xiaoshubaoVIP/XP02_WR/File/XP02/03 详设方案/05 PCBA生产文件/PCB板,XP02主板PCB,FR-4,94V0,板厚1.6mm,黑油白字,双层板/gerber/钢网拼板资料/钢网制作要求/钢网制作要求.docx

如图：

钢网开孔，把中间孔堵住。

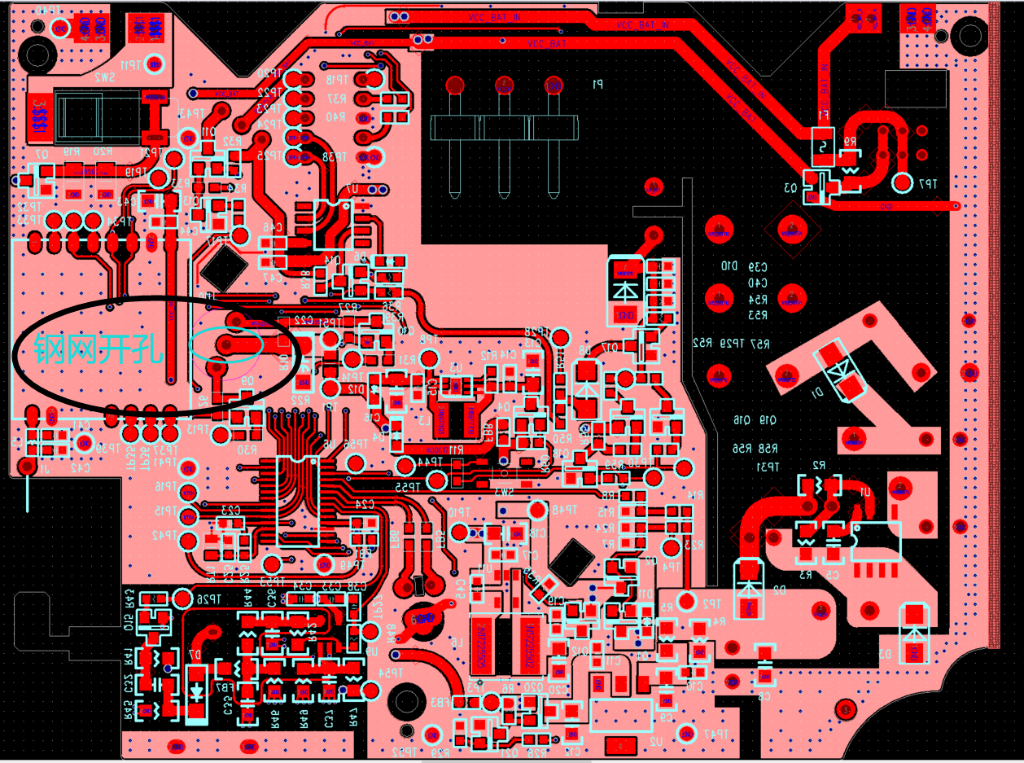
[picture p12: figure]
