xiaoshubaoVIP/XP02_WR/File/XP02/03 详设方案/04 PCB文件/PCB板,XP01_V2.0主板PCB,FR-4,94V0,板厚1.6mm,黑油白字,双层板/BOM--SMD和PCBA加工物料/PCBA,XP01主板,TUVUL,BA45F5260方案,复合烟雾碳感报警器.xlsx

BOM层级 | 子项物料编码 | 物料名称 | 规格型号 | 单位 | 实际数量 | 位置号 | 备注
0 |  |  |  | Pcs | 1
.1 | Y.2.12.XP0103 | 第八版新迷宫组件 | 迷宫组件,第八版新迷宫,PC 945NC,集耀对管 | Pcs | 1 | 主板位号U2
..2 | Y.2.01.XP0105 | 新迷宫上盖 | 第八版新迷宫上盖,XP01,PC 945NC,黑色抽粒料 | Pcs | 1
..2 | Y.2.02.XP0102 | 新迷宫下盖 | 第八版新迷宫下盖,XP01,PC 945NC,黑色抽粒料 | Pcs | 1
..2 | Y.2.07.XP0101 | 迷宫对管支架 | 迷宫对管支架,XP01,PC+ABS(AC3100),黑色 | Pcs | 1
..2 | Y.1.11.010010 | 红外发射管 | 集耀,940/L30022NC-4.3-V/L100887 | Pcs | 1
..2 | Y.1.11.010011 | 接射管 | 集耀,L30025PDC-4.3-V/L100888 | Pcs | 1
.1 | P.2.03.000022 | 电池 | BAT,锂电池,XP01,DC3V,CR17450,带电极焊片,插件,惠德瑞 | Pcs | 1
.1 | Y.1.30.010008 | 蜂鸣器 | 蜂鸣器,XP01,黑色,带耳朵,带线长50mm,带插座间距1.25mm,直径30.4mm,高度19mm,频率3.2KHZ(取消蜂鸣器内部电阻) | Pcs | 1 | 主板位号J6
.1 | Y.1.16.010006 | 连接线 | 连接线,1x4PIN,A面对B面,1.25mm,软线材,长50mm | Pcs | 1 | 主板位号CON3与XP01按键板J1连接
.1 | Y.1.29.010003 | CO传感器 | CO Sensor,一氧化碳传感器,Figaro,TGS5042-A00 | Pcs | 1 | 主板位号TP27/TP26
.1 | T.03.XP.01001 | PCBA | PCBA,XP01按键板 | Pcs | 1
..2 | T.04.XP.01007 | PCB板 | PCB板,XP01按键板PCB,FR-4,94V0,板厚1mm,黑油白字,双层板(2021-12-7) | Pcs | 1
..2 | Y.1.02.020049 | 电阻 | RES,SMD,100R,5%J,1/16W,0402 | Pcs | 4 | R1,R2,R3,R4
..2 | Y.1.09.020037 | 贴片LED | 侧面红色led发光二极管,贴片0805封装 | Pcs | 2 | D1,D2
..2 | Y.1.09.020038 | 贴片LED | 侧面绿色led发光二极管,贴片0805封装 | Pcs | 2 | D3,D4
..2 | Y.1.20.020023 | 贴片按键 | KEY,轻触按键,K2-8816SP-A5SW-01 300G,防腐蚀,8*8.7*4mm,RoHS | Pcs | 1 | KEY1
..2 | Y.1.19.020054 | 立式连接座 | CONN,连接座,1x4PIN,SMT,1.25mm,Vertical,RoHS | Pcs | 1 | J1
.1 |  | PCBA | PCBA,XP01主板,TUV/UL,BA45F5260方案,复合烟雾碳感报警器 | Pcs | 1
..2 |  | PCB板 | PCB,XP01,V0.1,主板,FR4,96*85.3,板厚1.6mm,双层板,沉金,黑油白字,阻抗控制（BA45F5260方案） | Pcs | 1
..2 | Y.1.03.020082 | 电容 | CAP,陶瓷电容,SMD,22uF,20%M,16V,X5R,0805 | Pcs | 3 | C1,C2,C21
..2 | Y.1.03.020093 | 电容 | CAP,陶瓷电容,SMD,100nF,10%K,50V,X7R,0603 | Pcs | 6 | C3,C4,C8,C15,C17,C22
..2 | Y.1.03.020103 | 电容 | CAP,陶瓷电容,SMD,1uF,10%K,25V,X7R,0805 | Pcs | 1 | C12
..2 | Y.1.03.020006 | 电容 | CAP,陶瓷电容,SMD,1uF,10%K,16V,X7R,0603 | Pcs | 1 | C16
..2 | Y.1.03.020041 | 电容 | CAP,陶瓷电容,SMD,1nF,10%K,50V,X7R,0603 | Pcs | 1 | C9
..2 | Y.1.03.020015 | 电容 | CAP,陶瓷电容,SMD,470pF,5%J,50V,NP0,0603 | Pcs | 1 | C10
..2 | Y.1.03.020107 | 电容 | CAP,陶瓷电容,SMD,100pF,5%J,25V,NPO,0805 | Pcs | 1 | C13
..2 | Y.1.03.020102 | 电容 | CAP,陶瓷电容,SMD,56pF,5%J,50V,NPO,0805 | Pcs | 2 | C14,C18
..2 | Y.1.03.020153 | 电容 | CAP,电解电容,SMD,330uF,20%M,6.3V,D6*L7 | Pcs | 1 | C6
..2 | Y.1.03.020151 | 电容 | CAP,陶瓷电容,SMD,5.6pF,5%J,50V,NP0,0402 | Pcs | 1 | C20
..2 | Y.1.03.020044 | 电容 | CAP,陶瓷电容,SMD,10uF,20%M,16V,X5R,0603 | Pcs | 1 | C5
..2 | Y.1.02.020018 | 电阻 | RES,SMD,0R,5%J,1/8W,0805 | Pcs | 1 | R5
..2 | Y.1.02.020280 | 电阻 | RES,SMD,680R,1%F,1/8W,0805 | Pcs | 1 | R6
..2 | Y.1.02.020224 | 电阻 | RES,SMD,56R,1%F,1/10W,0603 | Pcs | 1 | R7
..2 | Y.1.02.020131 | 电阻 | RES,SMD,100K,1%F,1/8W,0805 | Pcs | 2 | R13,R17
..2 | Y.1.02.020115 | 电阻 | RES,SMD,10K,1%F,1/10W,0603 | Pcs | 1 | R14
..2 | Y.1.02.020128 | 电阻 | RES,SMD,10K,1%F,1/8W,0805 | Pcs | 1 | R18
..2 | Y.1.02.020017 | 电阻 | RES,SMD,1K,5%J,1/8W,0805 | Pcs | 2 | R15,R21
..2 | Y.1.02.020127 | 电阻 | RES,SMD,1.6M,1%F,1/8W,0805 | Pcs | 1 | R16
..2 | Y.1.02.020098 | 电阻 | RES,SMD,47K,1%F,1/10W,0603 | Pcs | 1 | R19
..2 | Y.1.02.020129 | 电阻 | RES,SMD,2.49M,1%F,1/8W,0805 | Pcs | 1 | R20
..2 | Y.1.02.020094 | 电阻 | RES,SMD,1K,1%F,1/16W,0402 | Pcs | 1 | R11
..2 | Y.1.02.020114 | 电阻 | RES,SMD,5.6K,1%F,1/10W,0603 | Pcs | 1 | R8
..2 | Y.1.02.020239 | 电阻 | RES,SMD,2R,1%F,1/10W,0603 | Pcs | 1 | R9
..2 | Y.1.02.020108 | 电阻 | RES,热敏电阻,SMD,NTC,R25=100K,B=4250K,5%J,0805 | Pcs | 1 | RT1
..2 | Y.1.02.020097 | 电阻 | RES,SMD,100K,1%F,1/10W,0603 | Pcs | 1 | R10
..2 | Y.1.35.020004 | 贴片保险丝 | 保险丝,PTC自恢复保险丝,电压6V,跳闸电流1A,0805 | Pcs | 1 | F2
..2 | Y.1.25.020006 | 贴片磁珠 | FB,70R±25%@100MHZ,0805,RoHS | Pcs | 1 | FB7
..2 | Y.1.25.020007 | 贴片磁珠 | FB,60R±25%@100MHZ,0603,RoHS | Pcs | 6 | FB1,FB2,FB3,FB4,FB5,FB6
..2 | Y.1.09.020031 | 贴片二极管 | DIO,LL4148,SMD,LL-34,RoHS | Pcs | 1 | D1
..2 | Y.1.34.020008 | 贴片三极管 | 贴片三极管,NPN,S8050,SOT-23,RoHS | Pcs | 3 | Q1,Q2,Q3
..2 | Y.1.19.020054 | 立式连接座 | CONN,连接座,1x4PIN,SMT,1.25mm,Vertical,RoHS | Pcs | 2 | CON1,CON3
..2 | Y.1.19.020055 | 立式连接座 | CONN,连接座,1x3POS,SMT,1.25MM,Vertical,RoHS | Pcs | 2 | J6,CON2
..2 | Y.1.26.010005 | 插件电感 | 电感,L1-2: 2.3mH+L1-3: 44mH,10%,Φ10.5mm*14.5mm | Pcs | 1 | L1
..2 | Y.1.26.020030 | 贴片电感 | IND,6.8NH(HiQ),±5%,350mA,0402 | Pcs | 1 | L2
..2 | Y.3.02.XS0001 | 母接触片 | 母接触片,XS01,铍铜,热处理,先镀镍2~3um,再金1.0~1.5唛,T=0.2mm | Pcs | 1 | J3,母接触片
..2 | Y.3.02.XS0004 | 公接触片 | 公接触片(改模加大圆角),XS01,铍铜(C17200),热处理硬度HV335-350°,先镀镍2~3um,再镀金1.0~1.5唛,T=0.2mm | Pcs | 1 | J3,公接触片
..2 | Y.1.20.020022 | 贴片按键开关 | KEY,轻触按键,K2-1808SN-A3SW-01 180G,防腐蚀,4.20*3.25*2.3mm,RoHS | Pcs | 1 | KEY1
..2 | Y.1.04.020224 | IC | IC,LDO,SMD,CE6232A25M,SOT23-3,1.8V~8V,Vo=2.5V,500mA,Iq=0.8uA,芯力微 | Pcs | 1 | U1
..2 | Y.1.04.020162 | IC | IC,MCU,SMD,BA45F5260,SSOP28,2.2V~5.5V,8位,16Kb*16,合泰 | Pcs | 1 | U3
..2 | Y.1.04.020132 | IC | IC,单通道运放SGM8040-1YN5G/TR,SOT-23-5,RoHS | Pcs | 1 | U4
