xiaoshubaoVIP/XP02_WR/File/XP02/05 试产验证测试/03  DVT试产/XP02硬件生产测试项/测试工具清单.docx

XP02系列：

AR和WR测试工具如下：

### 1、

数量 | 规格描述 | 链接
4 | 0.56寸两线直流电压表，红色二线DC3.1 - 32V | https://item.taobao.com/item.htm?spm=2013.1.w4004-18048174082.12.77ac31efIs5RDn&id=567164459196
2 | 公牛空气开关小型1p+N 10A | https://detail.tmall.com/item.htm?id=521214183025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
200 | 红色led发光二极管，绿色led发光二极管
2 | 红黑，电源开关，带指示灯 | https://item.taobao.com/item.htm?id=12901705335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
2 | 带锁按键 | https://item.taobao.com/item.htm?spm=a1z10.5-c-s.w4002-22418909982.17.7ff963e0Ox59rA&id=536409083604
