xiaoshubaoVIP/XP02_WR/File/XP02/03 详设方案/04 PCB文件/PCB板,XP01_V2.0主板PCB,FR-4,94V0,板厚1.6mm,黑油白字,双层板/坐标文件/坐标.xls

PartType | RefDes | PartDecal | Pins | Layer | Orient. | X | Y | SMD | Glued
C-0805 | C1 | C-0805 | 2 | Bottom | 90 | 21.1 | -11.4 | Yes | No
C-0805 | C2 | C-0805 | 2 | Bottom | 0 | 8.483 | -25.07 | Yes | No
C-0603 | C3 | C-0603 | 2 | Bottom | 270 | 11.2 | -23.4 | Yes | No
C-0603 | C4 | C-0603 | 2 | Bottom | 270 | -0.5 | -25.561 | Yes | No
C-0603 | C5 | C-0603 | 2 | Bottom | 270 | -4.756 | -25.561 | Yes | No
C6377SMD | C6 | C6377SMD | 2 | Bottom | 270 | -16.9 | 2.75 | Yes | Yes
C-0603 | C8 | C-0603 | 2 | Bottom | 270 | -2.3 | -6.7 | Yes | No
C-0603 | C9 | C-0603 | 2 | Bottom | 0 | -3.8 | 8.8 | Yes | No
C-0603 | C10 | C-0603 | 2 | Bottom | 90 | -5.043 | 6.415 | Yes | No
C0805 | C11 | C0805 | 2 | Bottom | 180 | -11.099 | -20.675 | Yes | No
C0805 | C12 | C0805 | 2 | Bottom | 90 | -28.555 | -30.606 | Yes | No
C0805 | C13 | C0805 | 2 | Bottom | 270 | -22.574 | -23.4 | Yes | No
C0805 | C14 | C0805 | 2 | Bottom | 270 | -14.549 | -23.392 | Yes | No
C0603 | C15 | C0603 | 2 | Bottom | 270 | -7.882 | -25.498 | Yes | No
C0603 | C16 | C0603 | 2 | Bottom | 270 | -6.35 | -25.525 | Yes | No
C0603 | C17 | C0603 | 2 | Bottom | 90 | -8.114 | -30.222 | Yes | No
C0805 | C18 | C0805 | 2 | Bottom | 270 | -13.618 | -29.923 | Yes | No
C0402 | C19 | C0402 | 2 | Bottom | 0 | -9.4 | 43 | Yes | No
C0402 | C20 | C0402 | 2 | Bottom | 0 | -9.4 | 46 | Yes | No
C-0805 | C21 | C-0805 | 2 | Bottom | 90 | -22.939 | 19.857 | Yes | No
C-0603 | C22 | C-0603 | 2 | Bottom | 0 | -22.035 | 17.802 | Yes | No
MINI-CON4-1.3MM | CON1 | MINI-CON4-1.3MM | 6 | Bottom | 0 | 10 | 15 | Yes | Yes
MINI-CON3-1.3MM | CON2 | MINI-CON3-1.3MM | 5 | Bottom | 180 | -0.308 | 16.699 | Yes | Yes
MINI-CON4-1.3MM | CON3 | MINI-CON4-1.3MM | 6 | Bottom | 270 | -22.2 | 11.567 | Yes | No
D-1206 | D1 | D-1206 | 2 | Bottom | 0 | -28.721 | -23.907 | Yes | No
R0805 | F1 | R0805 | 2 | Bottom | 135.718 | 39.125 | -4.967 | Yes | Yes
R0805 | F2 | R0805 | 2 | Bottom | 180 | 40.993 | 0.042 | Yes | No
R-0603 | FB1 | R-0603 | 2 | Bottom | 90 | -0.499 | -6.727 | Yes | No
R-0603 | FB2 | R-0603 | 2 | Bottom | 0 | -13.3 | -6.9 | Yes | No
R-0603 | FB3 | R-0603 | 2 | Bottom | 0 | -22.035 | 16.06 | Yes | No
R0603 | FB4 | R0603 | 2 | Bottom | 0 | 7.3 | -2.2 | Yes | No
R0603 | FB5 | R0603 | 2 | Bottom | 0 | 7.3 | -0.7 | Yes | No
R0603 | FB6 | R0603 | 2 | Bottom | 180 | -10.6 | -1.7 | Yes | No
R0805 | FB7 | R0805 | 2 | Bottom | 180 | -25.541 | -22.031 | Yes | No
K3-1235S-L1 | J1 | K3-1235S-L1 | 3 | Bottom | 90 | -24.25 | 0 | Yes | Yes
TP-3X0.6 | J1+ | TP-3X0.6 | 1 | Bottom | 225.198 | 39.574 | -12.153 | No | Yes
TP-R60 | J2 | TP-R60 | 2 | Bottom | 90 | 35.639 | -2.191 | Yes | Yes
SW_SD25 | J3 | SW_SD25 | 5 | Bottom | 90 | 31.052 | -3.061 | No | Yes
BAT-XP01 | J4 | BAT-XP01AA | 2 | Bottom | 45 | 29.926 | -22.047 | No | Yes
BAT-XP01 | J5 | BAT-XP01 | 2 | Bottom | 45 | 27.978 | -20.186 | No | Yes
MINI-CON3-1.3MM | J6 | MINI-CON3-1.3MM | 5 | Bottom | 270 | 44.8 | 16.5 | Yes | Yes
H4.4-0.8/0.4-4 | J7 | H4.4-0.8/0.4-4AAA | 1 | Bottom | 66.849 | -9.078 | 48.5 | No | Yes
K2-1808SN-A | KEY1 | K2-1808SN-A | 4 | Bottom | 270 | -24.385 | 2.35 | Yes | Yes
LD_10A | L1 | LD_10A | 3 | Bottom | 247.954 | 34.943 | 21.713 | No | Yes
L-0402 | L2 | L-0402 | 2 | Bottom | 270 | -9 | 44.5 | Yes | No
SOT-23 | Q1 | SOT-23 | 3 | Bottom | 270 | 36.441 | 13.691 | Yes | No
SOT-23 | Q2 | SOT-23 | 3 | Bottom | 0 | 30.985 | 11.682 | Yes | No
SOT-23 | Q3 | SOT-23 | 3 | Bottom | 270 | -22.533 | -30.609 | Yes | No
R1210 | R1 | R1210 | 2 | Bottom | 0 | -28.369 | -10.079 | Yes | No
R1210 | R2 | R1210 | 2 | Bottom | 0 | -28.396 | -6.806 | Yes | No
R0603 | R3 | R0603 | 2 | Bottom | 270 | 30.552 | 7.757 | Yes | No
R0603 | R4 | R0603 | 2 | Bottom | 90 | 26 | -6.3 | Yes | No
R0805 | R5 | R0805 | 2 | Bottom | 270 | 27.438 | -10.601 | Yes | No
R0805 | R6 | R0805 | 2 | Bottom | 270 | -14.1 | -3.8 | Yes | No
R0603 | R7 | R0603 | 2 | Bottom | 270 | -4.3 | -6.5 | Yes | No
R0603 | R8 | R0603 | 2 | Bottom | 180 | 36.752 | 16.74 | Yes | No
R0603 | R9 | R0603 | 2 | Bottom | 270 | 39.355 | 13.369 | Yes | No
R-0603 | R10 | R-0603 | 2 | Bottom | 270 | -2.992 | 6.435 | Yes | No
R0402 | R11 | R0402 | 2 | Bottom | 0 | 27.707 | 11.625 | Yes | No
R0402 | R12 | R0402 | 2 | Bottom | 180 | 27.725 | 10.491 | Yes | No
R0805 | R13 | R0805 | 2 | Bottom | 90 | -26.258 | -30.606 | Yes | No
R0603 | R14 | R0603 | 2 | Bottom | 270 | -19.142 | -30.606 | Yes | No
R0805 | R15 | R0805 | 2 | Bottom | 0 | -17.368 | -22.247 | Yes | No
R0805 | R16 | R0805 | 2 | Bottom | 0 | -11.149 | -22.597 | Yes | No
R0805 | R17 | R0805 | 2 | Bottom | 0 | -25.523 | -25.827 | Yes | No
R0805 | R18 | R0805 | 2 | Bottom | 270 | -20.256 | -23.377 | Yes | No
R0603 | R19 | R0603 | 2 | Bottom | 90 | -10.075 | -30.222 | Yes | No
R0805 | R20 | R0805 | 2 | Bottom | 180 | -15.329 | -27.128 | Yes | No
R0805 | R21 | R0805 | 2 | Bottom | 270 | -16.047 | -29.923 | Yes | No
R0805 | RT1 | R0805 | 2 | Bottom | 270 | -7.225 | 6.505 | Yes | No
TP-1.0 | TP1 | TP-1.0 | 1 | Bottom | 0 | 26.9 | -14.9 | Yes | Yes
TP-1.0 | TP2 | TP-1.0 | 1 | Bottom | 0 | 45.49 | -0.14 | Yes | Yes
TP-1.0 | TP3 | TP-1.0 | 1 | Bottom | 0 | 9 | -33.3 | Yes | Yes
TP-1.0 | TP4 | TP-1.0 | 1 | Bottom | 0 | -2.791 | -24.394 | Yes | No
TP-1.0 | TP5 | TP-1.0 | 1 | Bottom | 0 | -17.906 | 8.628 | Yes | Yes
TP-1.0 | TP6 | TP-1.0 | 1 | Bottom | 0 | -7.873 | -1.735 | Yes | Yes
TP-1.0 | TP7 | TP-1.0 | 1 | Bottom | 0 | -8.687 | 13.797 | Yes | Yes
TP-1.0 | TP8 | TP-1.0 | 1 | Bottom | 0 | -8.687 | 17.296 | Yes | No
TP-1.0 | TP9 | TP-1.0 | 1 | Bottom | 0 | -31.006 | 4.328 | Yes | Yes
TP-1.0 | TP10 | TP-1.0 | 1 | Bottom | 0 | 45.217 | 20.028 | Yes | Yes
TP-1.0 | TP11 | TP-1.0 | 1 | Bottom | 0 | 45.214 | 12.958 | Yes | Yes
TP-1.0 | TP12 | TP-1.0 | 1 | Bottom | 0 | 47.216 | 16.503 | Yes | Yes
TP-1.0 | TP13 | TP-1.0 | 1 | Bottom | 0 | 5.876 | 12.072 | Yes | Yes
TP-1.0 | TP14 | TP-1.0 | 1 | Bottom | 0 | 9.3 | 12.021 | Yes | Yes
TP-1.0 | TP15 | TP-1.0 | 1 | Bottom | 0 | 13.43 | 12.021 | Yes | Yes
TP-1.0 | TP16 | TP-1.0 | 1 | Bottom | 0 | 17.208 | 12.021 | Yes | Yes
TP-1.0 | TP17 | TP-1.0 | 1 | Bottom | 0 | 25.233 | 10.624 | Yes | Yes
TP-1.0 | TP18 | TP-1.0 | 1 | Bottom | 0 | 10.772 | -8.263 | Yes | No
TP-1.0 | TP19 | TP-1.0 | 1 | Bottom | 0 | -1.383 | 19.629 | Yes | No
TP-1.0 | TP20 | TP-1.0 | 1 | Bottom | 0 | 1.524 | 21.139 | Yes | Yes
TP-1.0 | TP21 | TP-1.0 | 1 | Bottom | 0 | -28.04 | 15.25 | Yes | Yes
TP-1.0 | TP22 | TP-1.0 | 1 | Bottom | 0 | -28.04 | 12.468 | Yes | Yes
TP-1.0 | TP23 | TP-1.0 | 1 | Bottom | 0 | -28.04 | 9.753 | Yes | Yes
TP-1.0 | TP24 | TP-1.0 | 1 | Bottom | 0 | -28.04 | 7.016 | Yes | Yes
TP-1.0 | TP25 | TP-1.0 | 1 | Bottom | 0 | -18.884 | -33.27 | Yes | Yes
PAD50X23 | TP26 | PAD50X23A | 1 | Bottom | 0 | -28.5 | -17.2 | No | Yes
PAD50X23 | TP27 | PAD50X23B | 1 | Bottom | 0 | -28.5 | 33.4 | No | Yes
TP-1.0 | TP28 | TP-1.0 | 1 | Bottom | 0 | -4.977 | -30.674 | Yes | Yes
TP-1.0 | TP29 | TP-1.0 | 1 | Bottom | 0 | 0 | 25.322 | Yes | Yes
TP-1.0 | TP30 | TP-1.0 | 1 | Bottom | 0 | -4.124 | 23.219 | Yes | Yes
TP-1.0 | TP31 | TP-1.0 | 1 | Bottom | 0 | -3.989 | 28.474 | Yes | Yes
TP-1.0 | TP32 | TP-1.0 | 1 | Bottom | 0 | -19.209 | 43.649 | Yes | Yes
TP-1.0 | TP33 | TP-1.0 | 1 | Bottom | 0 | -21.217 | 43.649 | Yes | Yes
TP-1.0 | TP34 | TP-1.0 | 1 | Bottom | 0 | -23.212 | 43.649 | Yes | Yes
TP-1.0 | TP35 | TP-1.0 | 1 | Bottom | 0 | -15 | 43.649 | Yes | Yes
TP-1.0 | TP36 | TP-1.0 | 1 | Bottom | 0 | 19.429 | -26.584 | Yes | Yes
SOT-23 | U1 | SOT-23 | 3 | Bottom | 0 | 3.676 | -23.815 | Yes | No
SMOKE-8 | U2 | SMOKE-8 | 11 | Top | 0 | 0.045 | -0.029 | No | Yes
SSOP28 | U3 | SSOP28 | 28 | Bottom | 0 | 4 | -3 | Yes | Yes
SOT23_5 | U4 | SOT23-5 | 5 | Bottom | 90 | -10.058 | -27.605 | Yes | No
LSD4RF-2F717N30 | U5 | LSD4RF-2F717N30 | 14 | Bottom | 90 | -16.1 | 32 | Yes | Yes
