xiaoshubaoVIP/XP02_WR/(list of files, cad)

Other CAD files:
Code/XP03_Pjo/XP03_B/main.OBJ
Code/XP03_Pjo/XP03_B/PwrManager.OBJ
Code/XP03_Pjo/XP03_B/startup1.OBJ
Code/XP03_Pjo/XP03_B/Holtek_Timer.OBJ
Code/XP03_Pjo/XP03_B/usart.OBJ
Code/XP03_Pjo/XP03_B/RF.OBJ
Code/XP03_Pjo/XP03_B/WiredNet.OBJ
Code/XP03_Pjo/XP03_B/Adc.OBJ
Code/XP03_Pjo/XP03_B/Polling.OBJ
Code/XP03_Pjo/XP03_B/Smoke.OBJ
Code/XP03_Pjo/XP03_B/startup1_l.OBJ
Code/XP03_Pjo/XP03_B/Key.OBJ
Code/XP03_Pjo/XP03_B/Co.OBJ
Code/XP03_Pjo/XP03_B/Speaker.OBJ
Code/XP03_Pjo/XP03_B/E2prom.OBJ
Code/XP03_Pjo/XP03_B/startup0_l.OBJ
Code/XP03_Pjo/XP03_B/KeyAnalysis.OBJ
