xiaoshubaoVIP/XP02_WR/File/XP02/04 调试测试/01 硬件调试报告/硬件调试报告（XP02）.xlsx

 |  | 硬件调试报告 |  |  | Doc Rev.(文件版本) | V1.0
 |  |  |  |  | Page No.(页码) | 1 of 1
项目名称 | XP02AC烟感 | 板名 | XP02 |  | 版本 | V0.4
调试人员 | 龙金伟 | 调试日期 |  |  | 备注 | OK:通过；POK：部分通过； NG：不通过；NT：未测试
注：硬件调试报告的目的——新项目开发，电路板回板后，需对电路板上的各电路模块与接口进行调试，确认板上的所有电路功能/接口均达到预期功能，板子能满足后续软件开发，以及硬件详细单元测试。调试过程中发现的问题以及修改点可以进行记录，需要改板/BOM变动时，可以以表单记录内容作为回溯确认，避免遗漏。调试内容根据实际项目进行调整。
No. | 硬件功能/接口调试项目 | 详细调试内容与标准 | 调试结果 | 详细结果/问题记录 | 修改点 | 备注
1 | AC-DC 6.5V输出 | AC电源90~230V转DC6.5V，电压误差标准： | OK | 空载输出6.5V，满载输出6.2V
2 | LD0 3.6输出 | 使用AC电源时，输出供电为3.6V给系统 | OK | 空载输出3.6V，满载输出3.4V
3 | DC-DC 3.3V输出 | 电源模块3.3V输出是否满足预期/指标要求，电压误差标准： | OK | 输出电压3.3V
4 | 软件烧写 | 使用软件烧写口烧写软件，烧写后可以正常运行 | OK | 能正常烧录
5 | 串口输出 | 软件正常运行后，串口可以正常输出信息 | OK | 串口输出正常
6 | 按键确认 | 确认各按键功能正常 | OK | 按键功能正常
7 | 烟雾检测功能与灵敏度 | 确认烟雾检测功能与灵敏度 | POK | OBS：0.2-0.25 |  | 试产机器验证
8 | CO检测功能 | CO检测功能与灵敏度 | NT |  |  | 试产机器验证
9 | 蜂鸣器驱动 | 蜂鸣片能正常工作，配套结构手板测试分贝需满足＞95DB | OK | ＞95DB
10 | 喇叭 | 播放，语音曲目 | OK | 曲目音量比竞品大
11 | 指示灯 | 指示灯控制、工作正常 | OK | 显示正常
12 | 电池容量检测 | 电池容量检测功能正常 | OK | 低于2.7V低电报警
13 | 防雷防浪涌 | AC220V输入，浪涌组合波2.4K | OK | DC输出正常
14 | 有线通信 | 通信互联功能正常 | OK | 正常
15 | 功耗测试 | 测试待机和运行功耗 | NT | 平均待机功耗： |  | 试产机器验证
16 | RF915模块 | MCU和RF模块通信验证正常 | OK | 正常 |  | 联动试产机器验证
17 | 结构适配 | 结构与电路板试装，无干涉，接口位置正确 | OK | 匹配OK
 |  | Prepared By (编写): | 龙金伟 |  | Approval by (审核):
 |  | Date (日期): | 2022-03-17 |  | Date (日期):
