xiaoshubaoVIP/XP02_WR/File/XP02/04 调试测试/03 性能摸底测试报告/硬件性能摸底测试报告/XP02-T1壳方向性与低风速测试.xlsx

XP02（420mV）不可更换电池版本
方向 | 0° | 45° | 90° | 135° | 180° | 225° | 270° | 315° | MAX | MIN | 差值
uA | 83.80 | 86.60 | 88.20 | 85.50 | 84.60 | 81.20 | 86.20 | 86.80 | 88.20 | 80.50 | 7.70
 | 84.80 | 85.80 | 88.20 | 84.60 | 84.60 | 80.50 | 87.00 | 87.00
方向 | 0° | 45° | 90° | 135° | 180° | 225° | 270° | 315° | MAX | MIN | 差值
0bs | 0.18 | 0.25 | 0.20 | 0.20 | 0.21 | 0.20 | 0.20 | 0.24 | 0.25 | 0.18 | 0.07
 | 0.19 | 0.24 | 0.20 | 0.20 | 0.20 | 0.20 | 0.19 | 0.24
样机 | 灵敏度dB/m | 样机 | 灵敏度dB/m | 方向 | 最高灵敏度方向/90° | 最低灵敏度方向/225° | 最高灵敏度方向/90° | 最低灵敏度方向/270°
1# 灵敏度 |  | 2# 灵敏度 |  | 风速 | 9V | 9V | 13V | 13V
 |  |  |  | 1# 灵敏度uA | 88.20 | 81.20 |  |  | #DIV/0!
 |  |  |  |  | 88.20 | 80.50
 |  |  |  | 2# 灵敏度OBS | 0.18 | 0.25 |  |  | #DIV/0!
 |  |  |  |  | 0.19 | 0.25
XP02（420mV）可更换电池版本
方向 | 0° | 45° | 90° | 135° | 180° | 225° | 270° | 315° | MAX | MIN | 差值
uA | 88.20 | 89.00 | 91.20 | 88.30 | 87.90 | 87.30 | 86.30 | 88.80 | 91.20 | 86.30 | 4.90
 | 87.20 | 87.00 | 90.30 | 88.70 | 88.30 | 88.30 | 86.30 | 89.00
方向 | 0° | 45° | 90° | 135° | 180° | 225° | 270° | 315° | MAX | MIN | 差值
0bs | 0.16 | 0.19 | 0.19 | 0.12 | 0.15 | 0.14 | 0.12 | 0.15 | 0.20 | 0.12 | 0.08
 | 0.15 | 0.20 | 0.19 | 0.15 | 0.16 | 0.14 | 0.12 | 0.15
样机 | 灵敏度dB/m | 样机 | 灵敏度dB/m | 方向 | 最高灵敏度方向/90° | 最低灵敏度方向/270° | 最高灵敏度方向/90° | 最低灵敏度方向/270°
1# 灵敏度 |  | 2# 灵敏度 |  | 风速 | 9V | 9V | 13V | 13V
 |  |  |  | 1# 灵敏度uA | 91.20 | 86.30 |  |  | #DIV/0!
 |  |  |  |  | 90.30 | 86.30
 |  |  |  | 2# 灵敏度OBS | 0.12 | 0.20 |  |  | #DIV/0!
 |  |  |  |  | 0.12 | 0.19
