xiaoshubaoVIP/XP02_WR/File/XP02/04 调试测试/03 性能摸底测试报告/硬件性能摸底测试报告/XP02-UL烟箱-八个方向摸底验证.docx

UL-不可更电池---低温天气（15-20度）
方向性 | 0 | 90 | 180 | 270
灵敏度 | 87.1 | 84.5 | 82.7 | 87.7
灵敏度 | 88.7 | 85 | 84.6 | 88.1

UL-可更电池---常温天气（23-26度），方向性和灵敏度，

方向性 | 0 | 45 | 90 | 135 | 180 | 225 | 270 | 315
灵敏度 | 88.2 | 89 | 91.2 | 88.3 | 87.9 | 87.3 | 86.3 | 88.8
灵敏度 | 87.2 | 87 | 90.3 | 88.7 | 88.3 | 87.4 | 86.3 | 89

UL-不可更电池---常温天气（23度-26度）

方向性 | 0 | 45 | 90 | 135 | 180 | 225 | 270 | 315
灵敏度 | 83.8 | 86.6 | 88.2 | 85.5 | 84.6 | 81.2 | 86.2 | 86.8
灵敏度 | 84.8 | 85.8 | 88.2 | 84.6 | 84.6 | 80.5 | 87 | 87

UL-可更电池版本与不可更电池版本，八个方向性都在正常范围内。灵敏度阀值
