xiaoshubaoVIP/XP02_WR/File/XP02/02 总体方案/总体方案框图.pdf

5

4

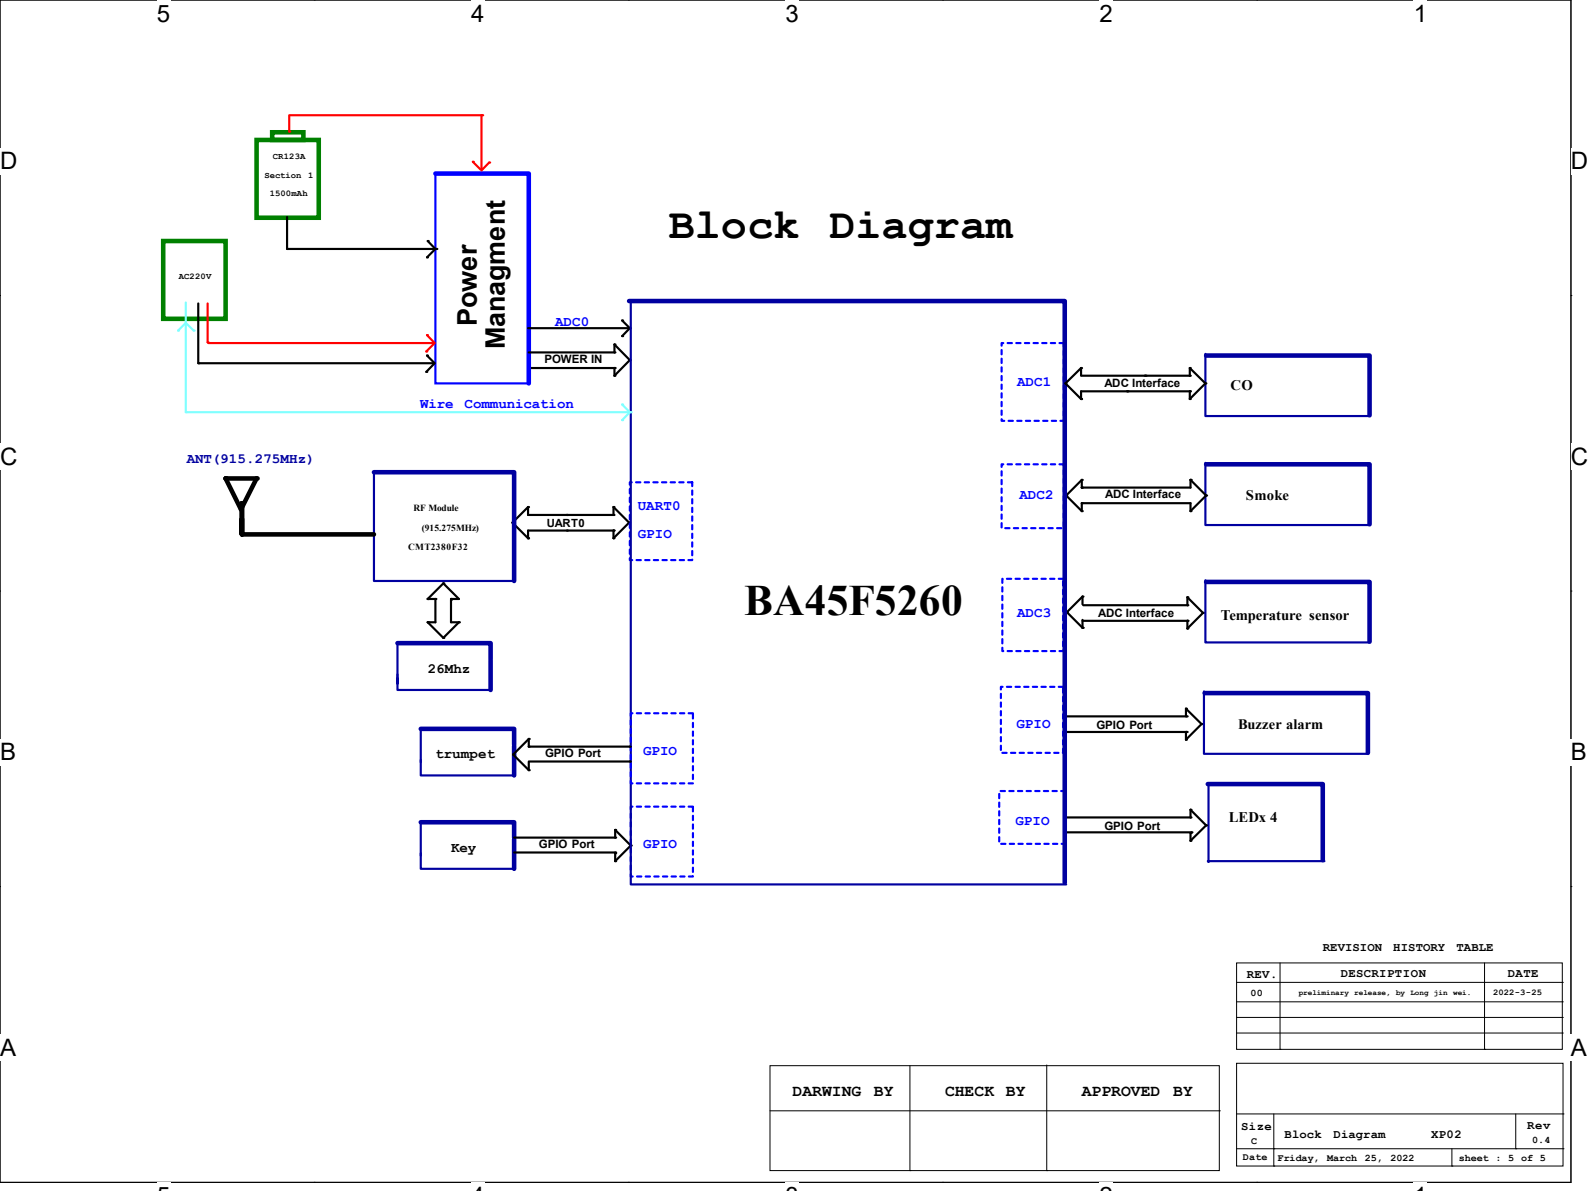
[picture p13: page 1]
Rev; Date; Friday, March 25, 2022; REV.; DATE; preliminary release, by Long jin wei.; sheet : 5 of 5; DARWING BY; CHECK BY; APPROVED BY; GPIO; ADC3; ADC Interface; Temperature sensor; ADC1; UART0; RF Module; (915.275MHz); CMT2380F32; ANT(915.275MHz); Section 1; 1500mAh; GPIO Port; Buzzer alarm; LEDx 4; ADC0; 26Mhz; Block Diagram; Key; ADC2; Smoke; trumpet; Wire Communication

POWER IN Power Managment

REVISION HISTORY TABLE
DESCRIPTION

0.4 Block Diagram Size
