xiaoshubaoVIP/XP02_WR/File/XP02/03 详设方案/02 原理图文件/V0.4（EVT版本）/XP02-主板原理图 V0.4.pdf

# AC 85~265V 50/60Hz

# AC-DC POWER

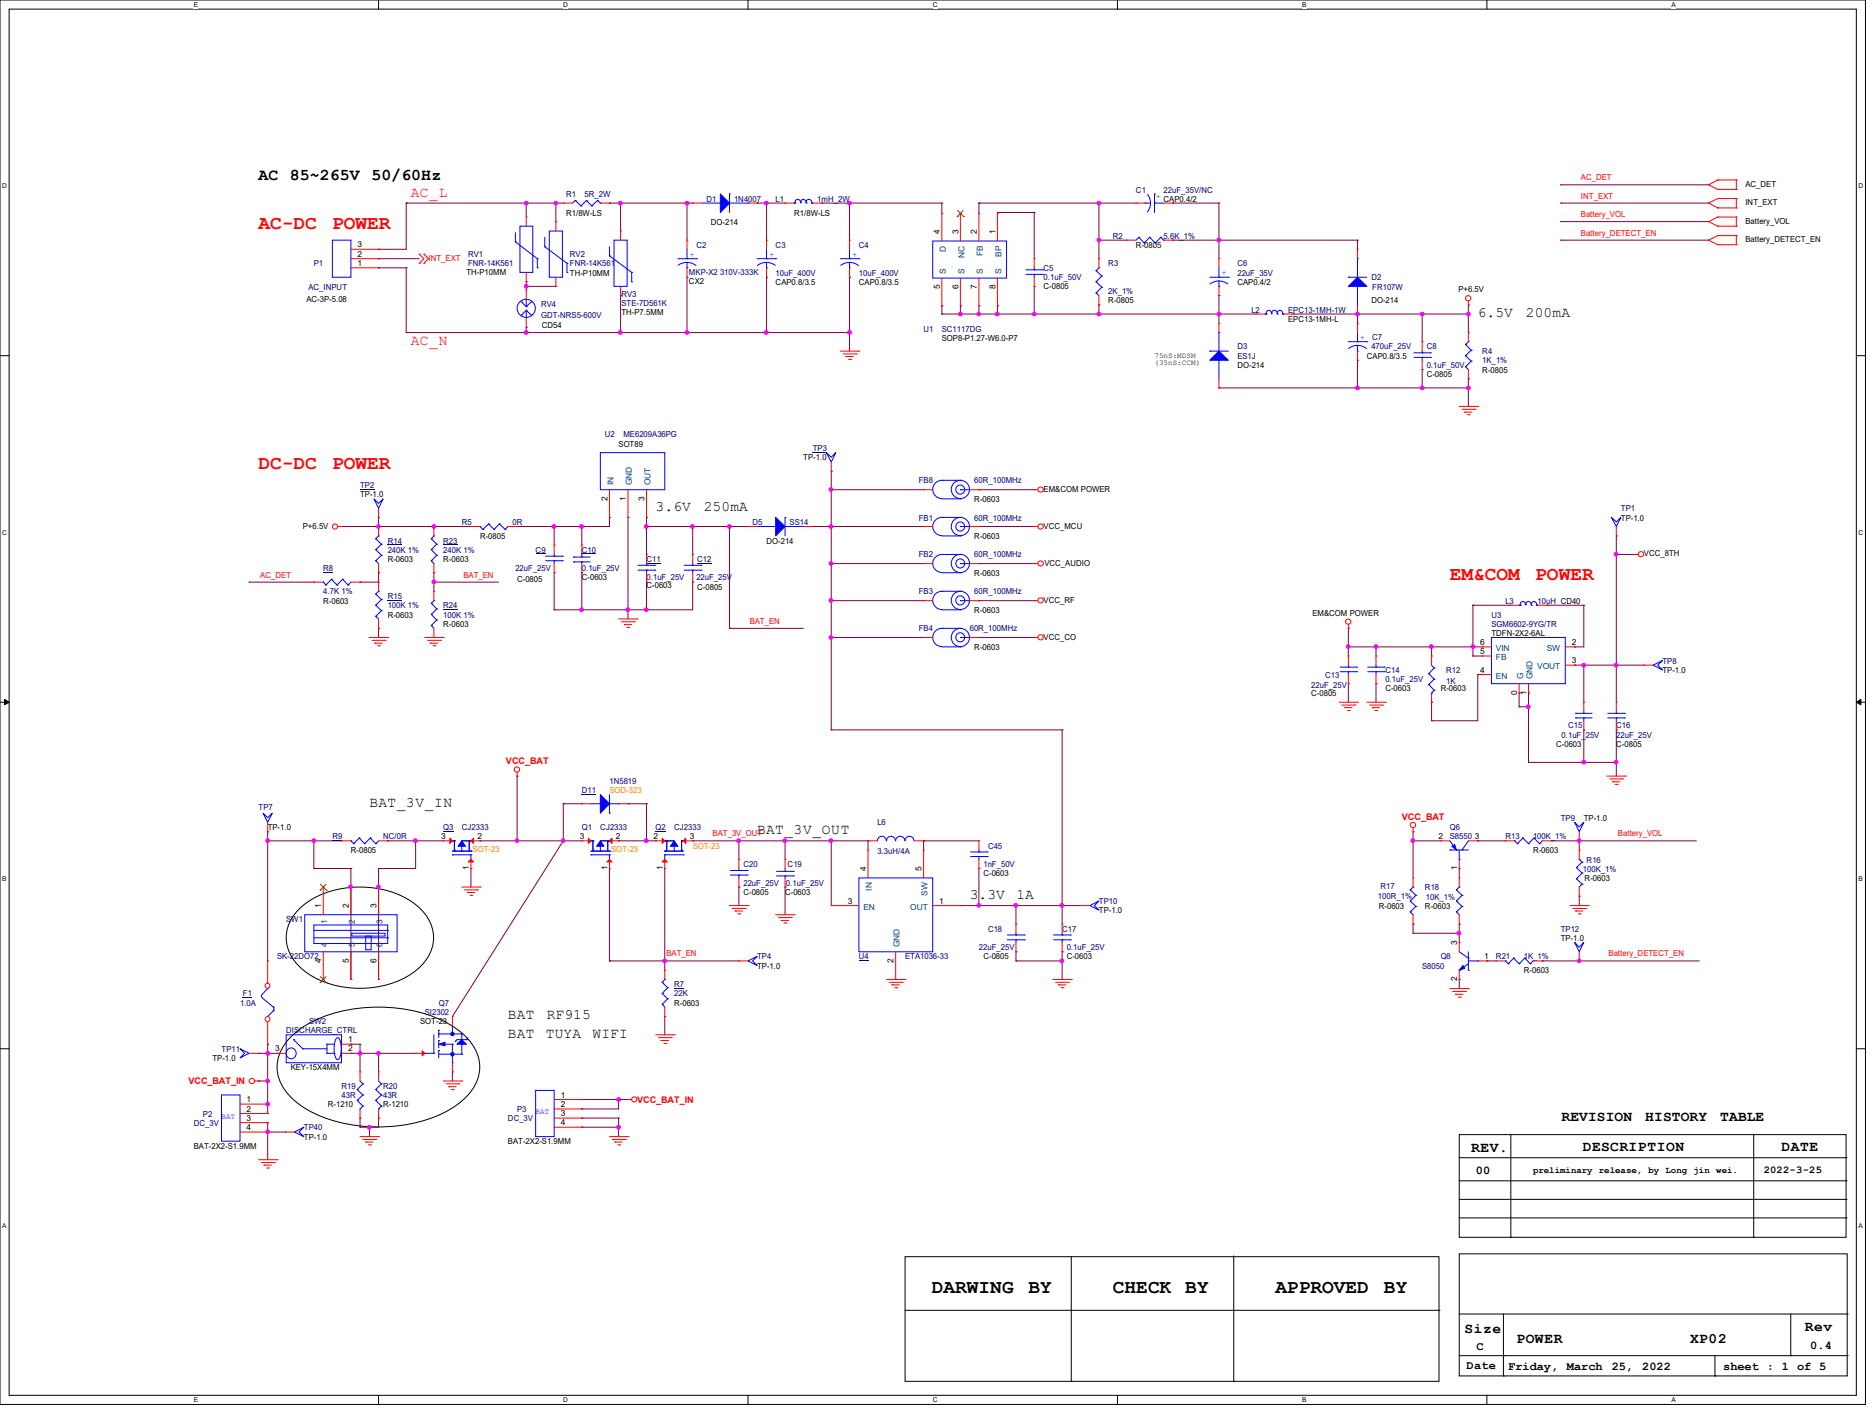
[picture p14: page 1]

1 SW 2 VOUT 3 EN 4 FB 5 VIN 6 G

# MCU

# SMOKE DETECTION

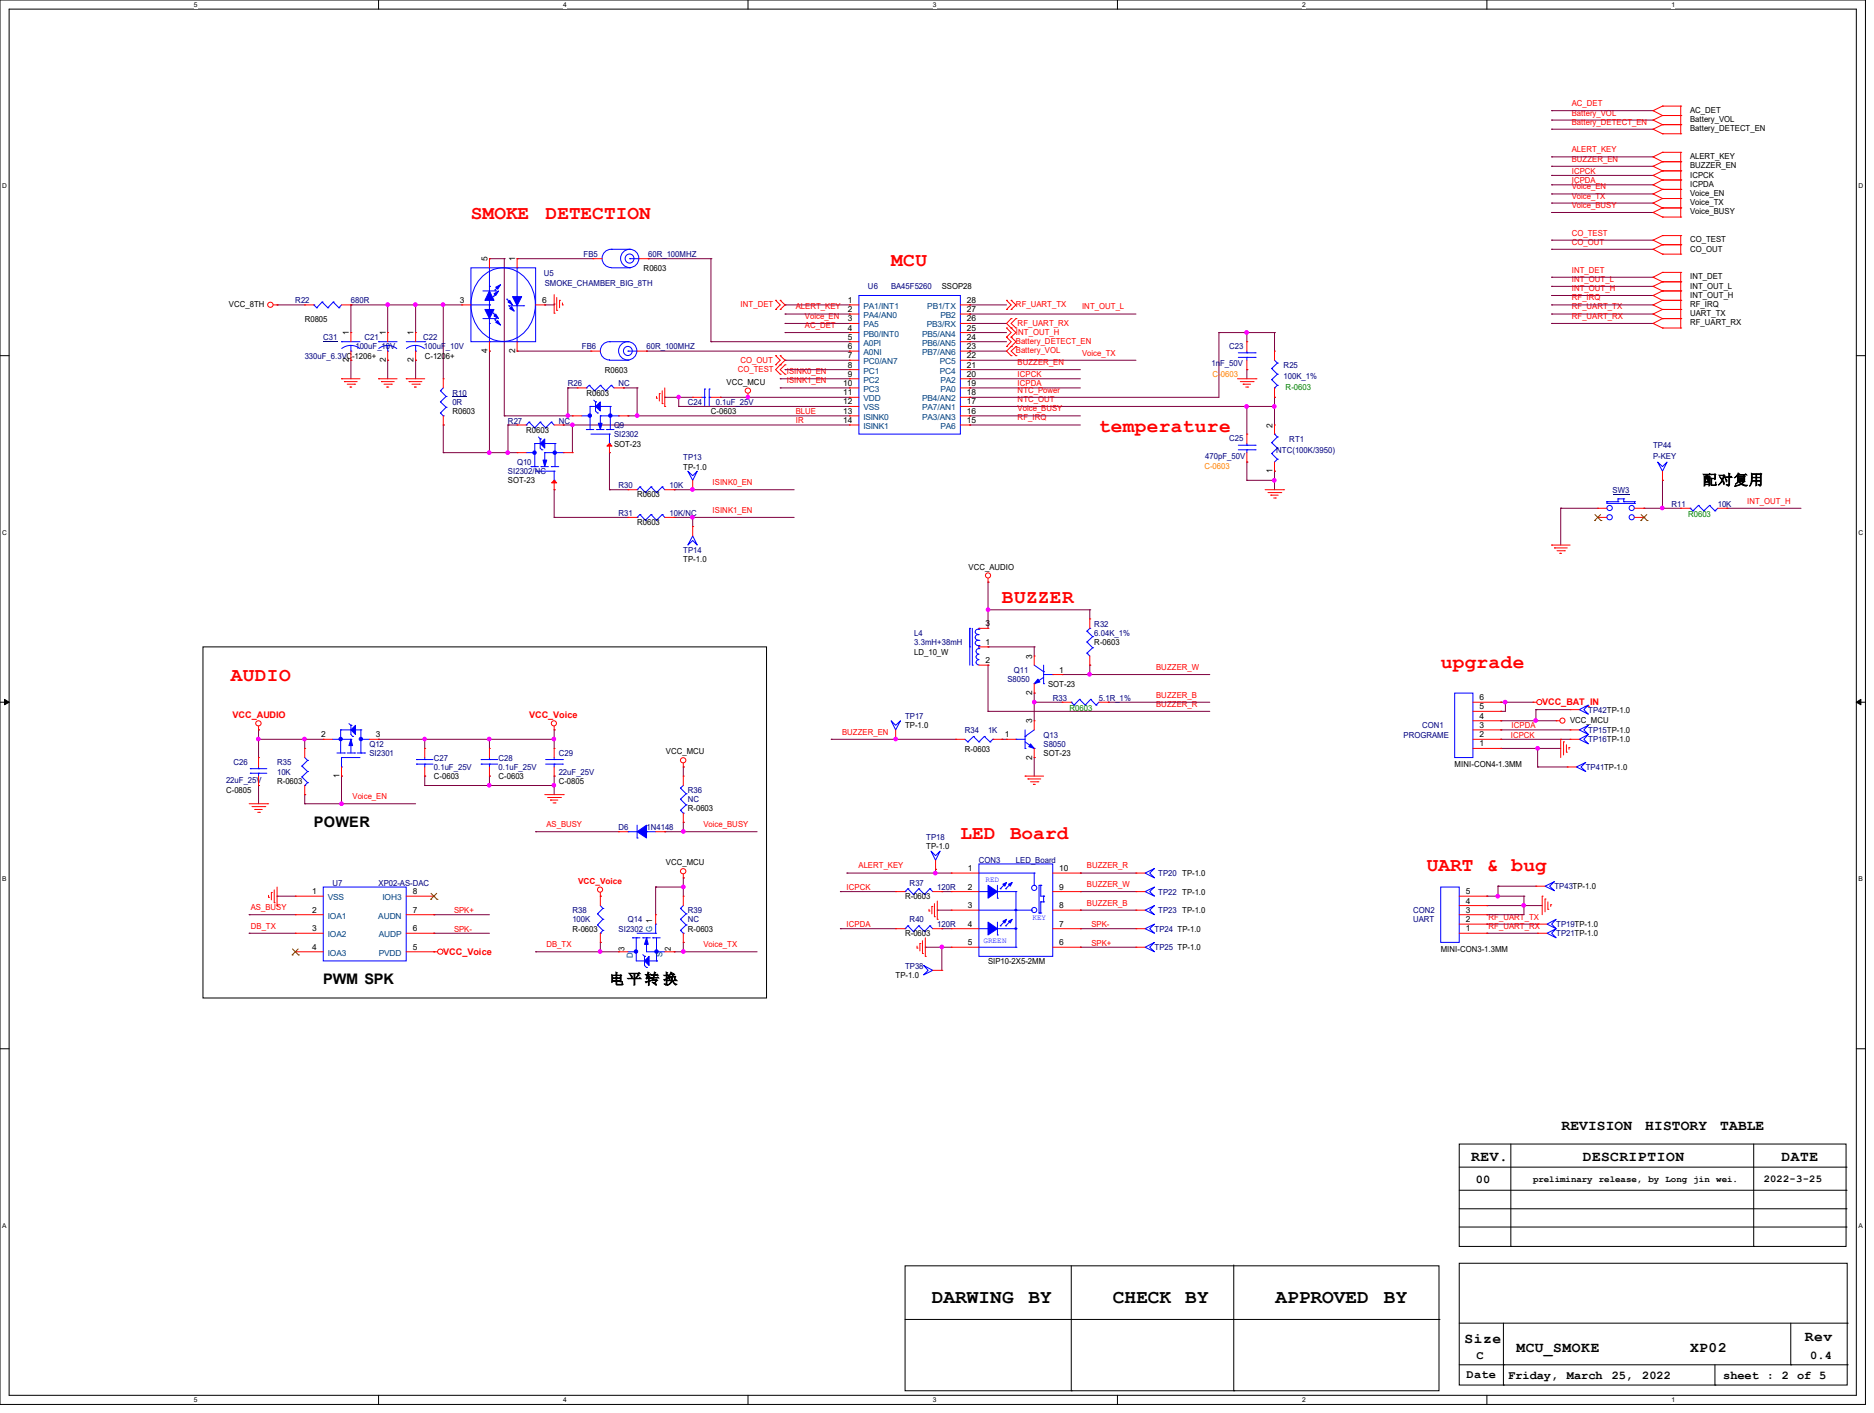
[picture p15: page 2]

# CO DETECTION

### Guard ring

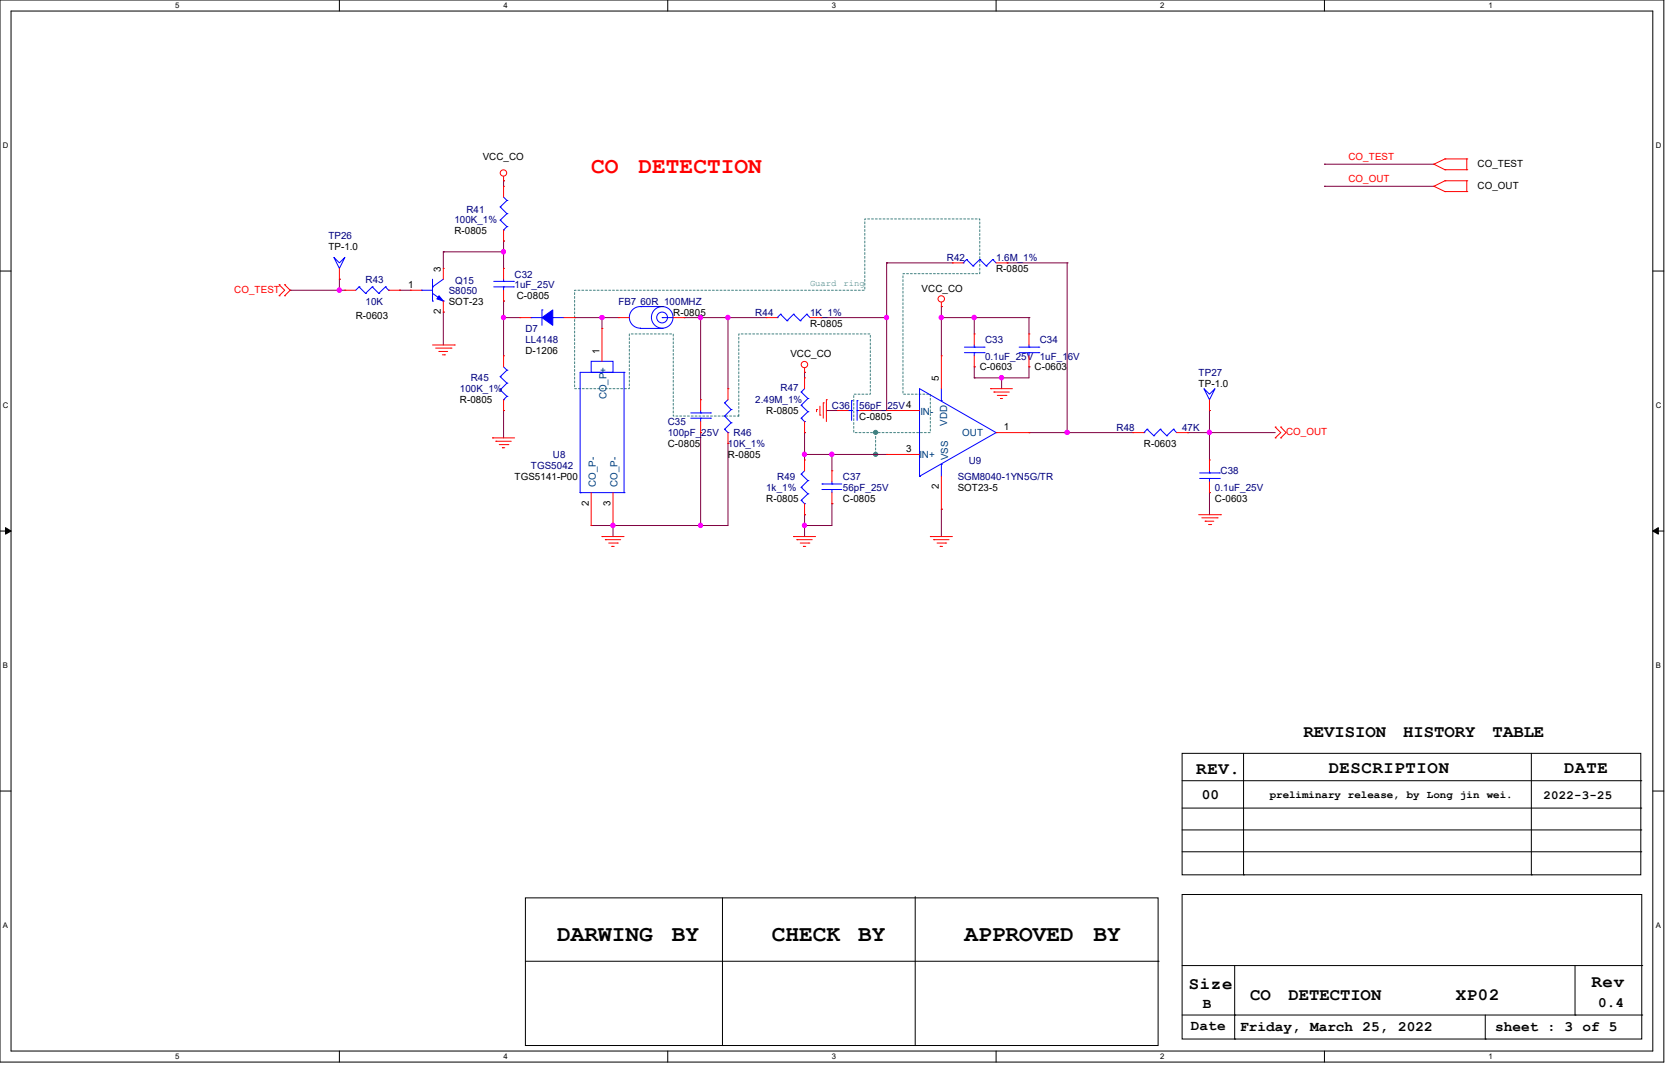
[picture p16: page 3]

# Wire Communication

# INT_EXT RF_IRQ

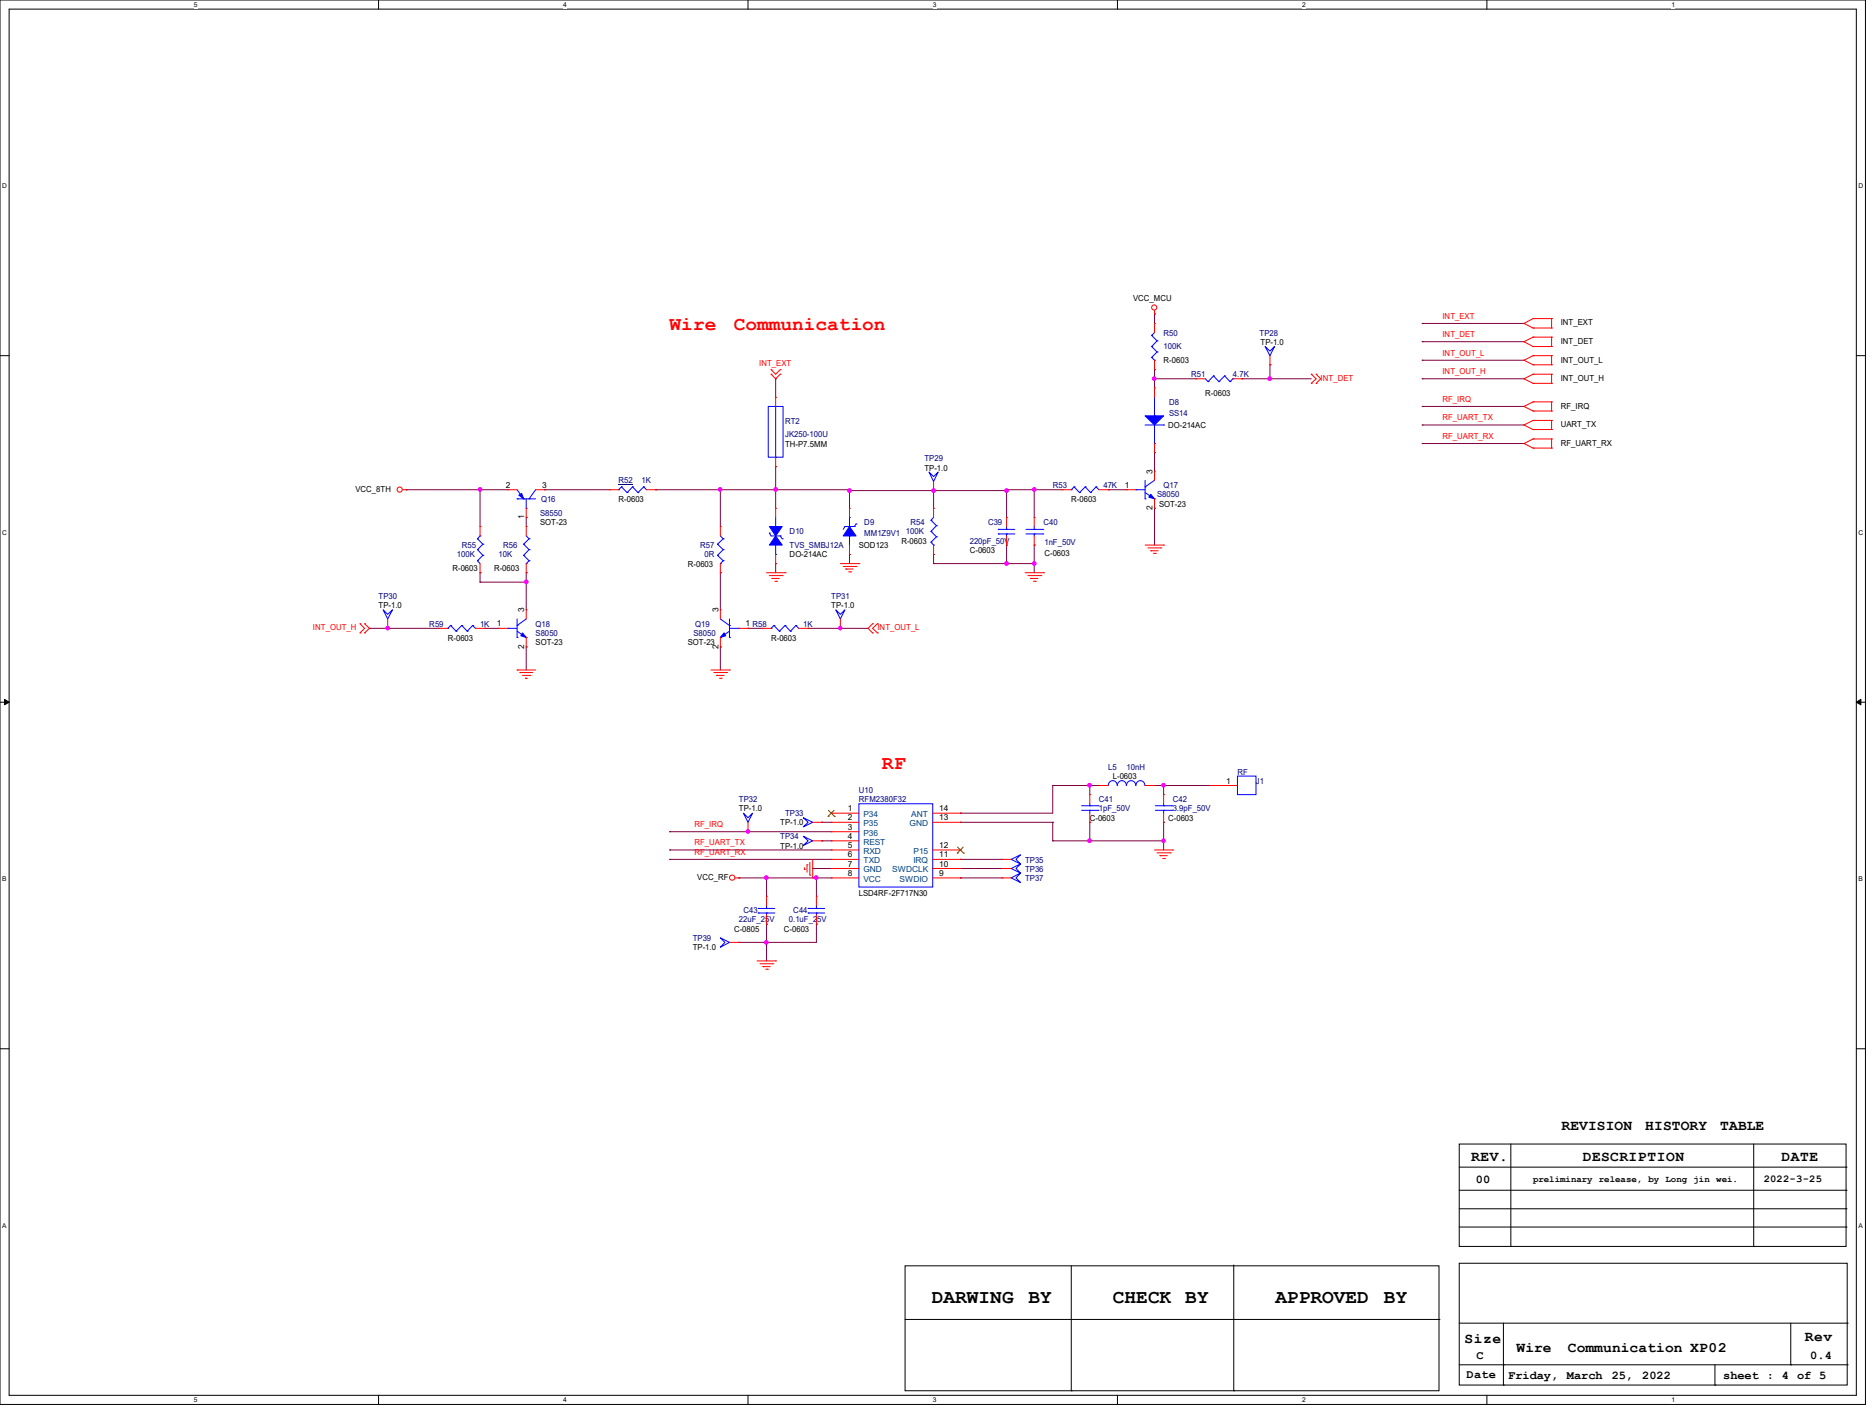
[picture p17: page 4]

D D

## POWER IN Power Managment

REV.; DATE; preliminary release, by Long jin wei.; sheet : 5 of 5; DARWING BY; CHECK BY; APPROVED BY; GPIO; ADC3; ADC Interface; Temperature sensor; ADC1; UART0; RF Module; (915.275MHz); CMT2380F32; ANT(915.275MHz); Section 1; 1500mAh; GPIO Port; Buzzer alarm; LEDx 4; ADC0; 26Mhz; Block Diagram; Key; ADC2; Smoke; trumpet; Wire Communication

REVISION HISTORY TABLE
DESCRIPTION

0.4 Block Diagram Size
