xiaoshubaoVIP/XP02_WR/File/XP02/03 详设方案/02 原理图文件/V0.6 (DVT版本）/XP02-主板-V0.6-2022-5-5.pdf

# Wire Communication

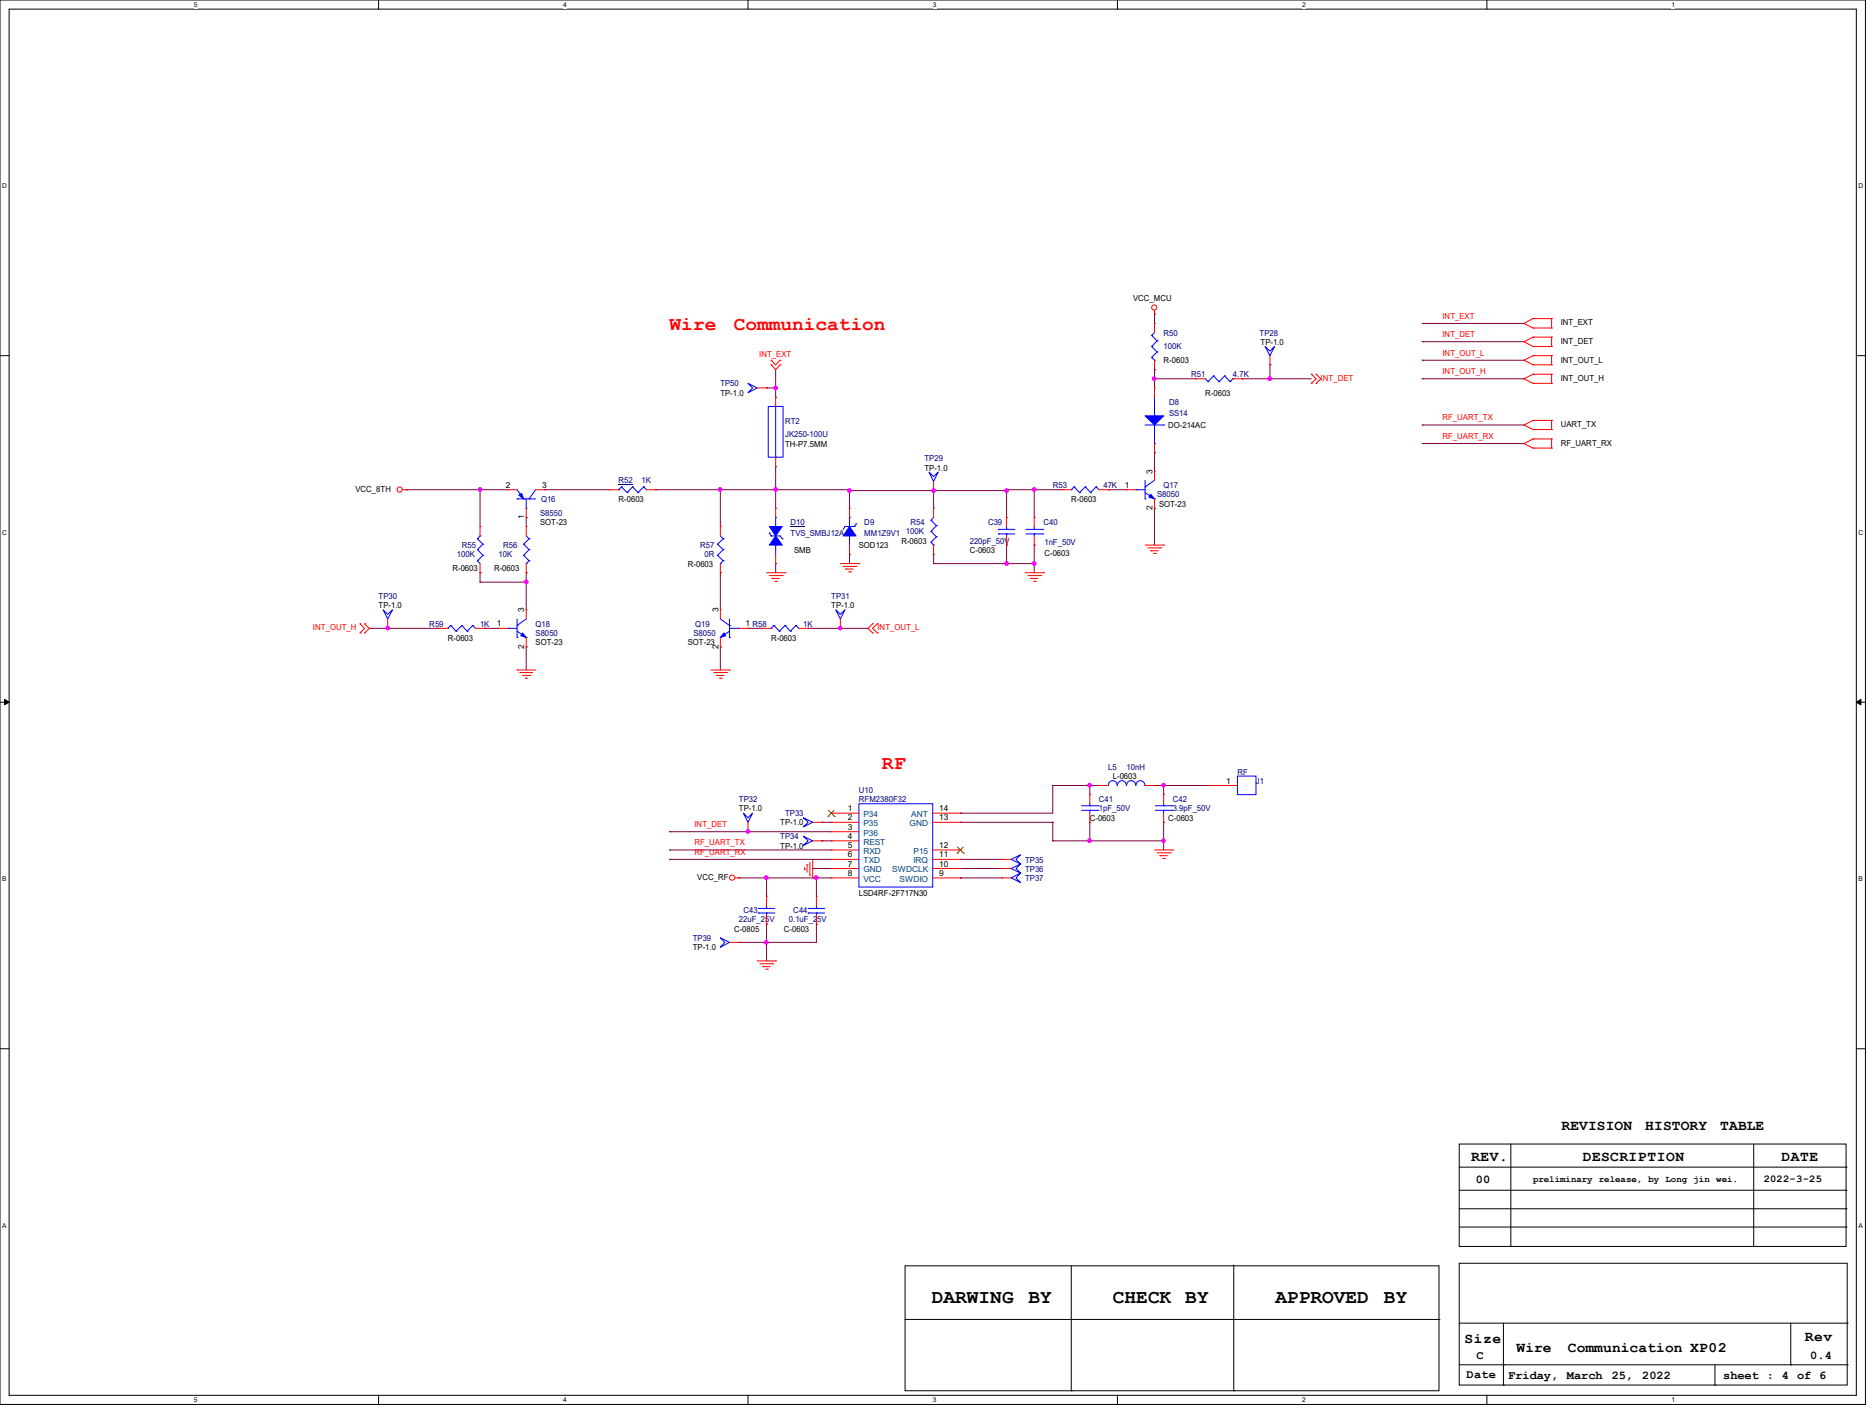
[picture p18: page 1]

# CO DETECTION

### Guard ring

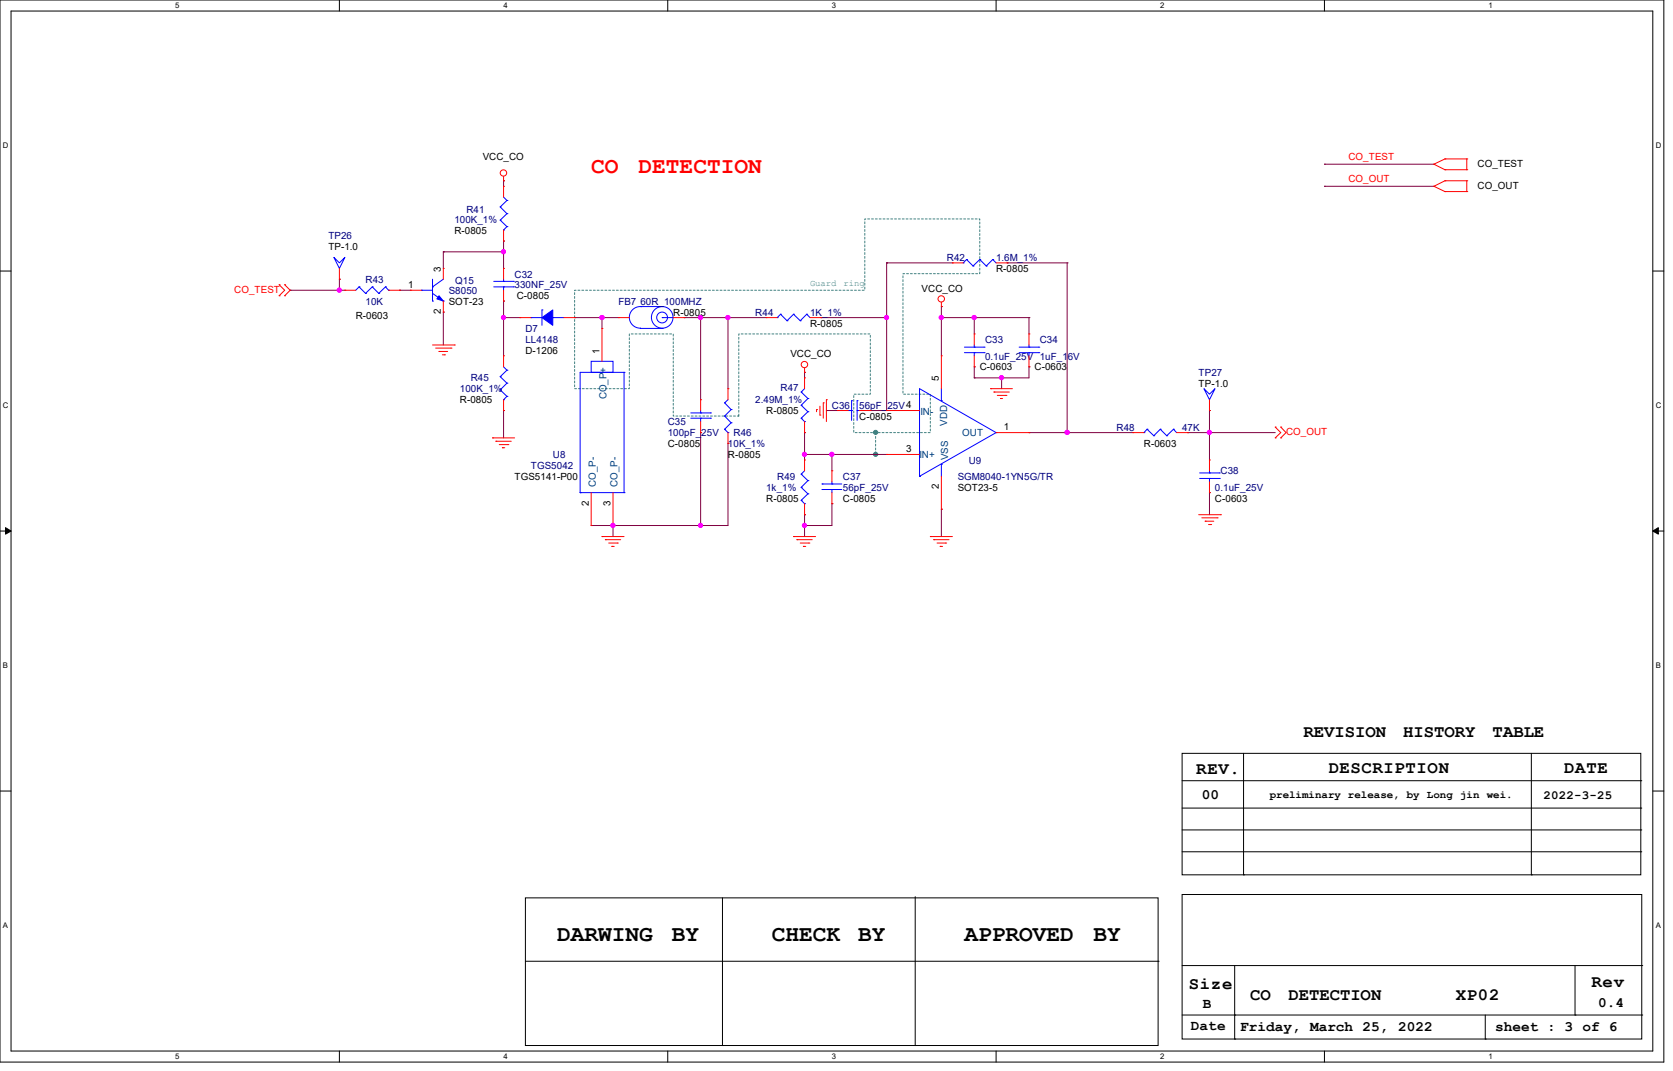
[picture p19: page 2]

# MCU

# SMOKE DETECTION

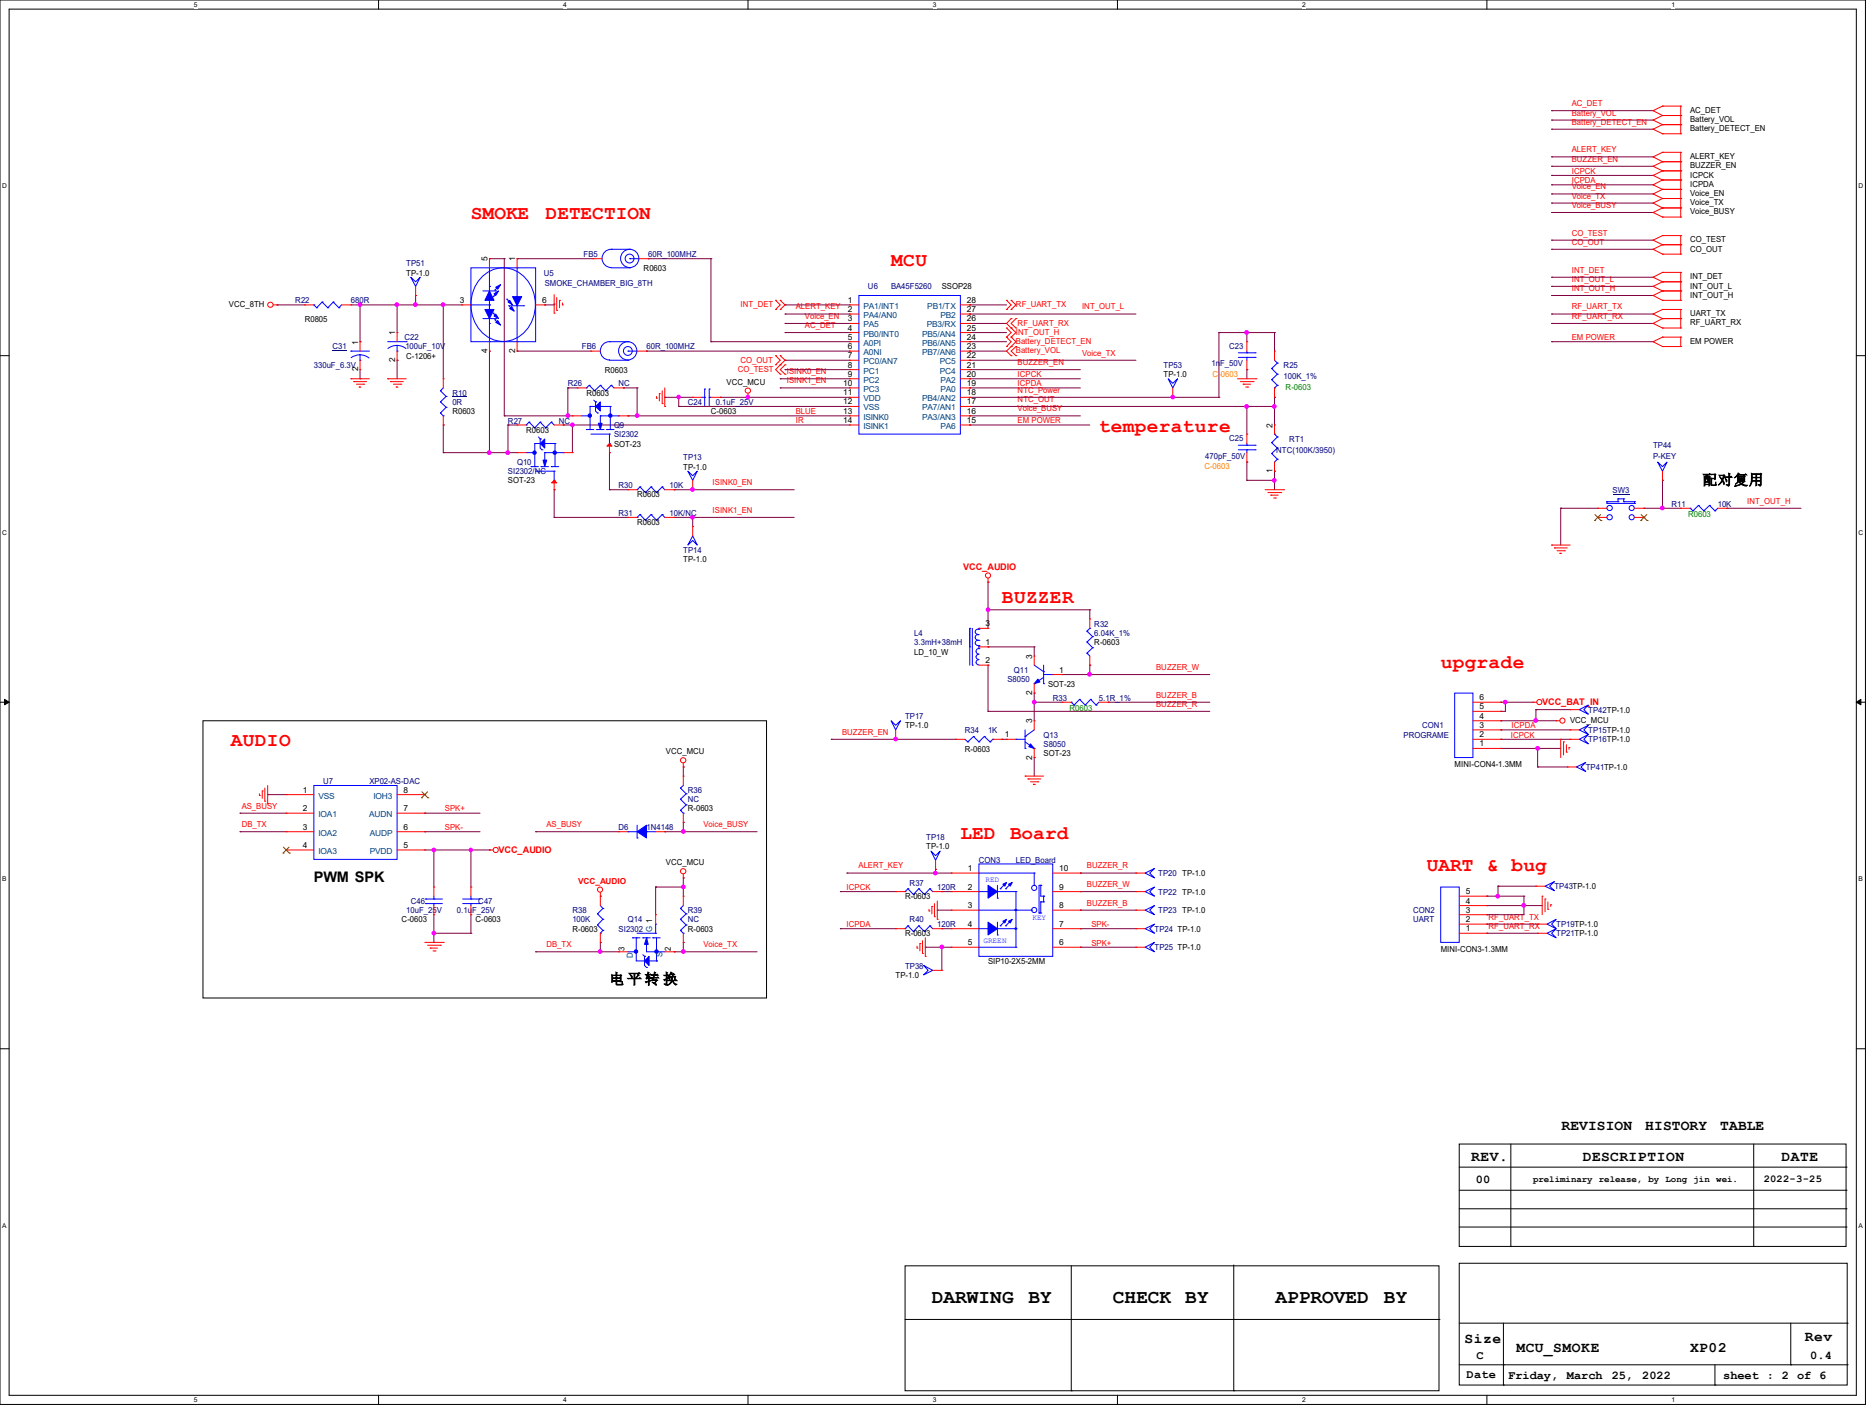
[picture p20: page 3]

# AC 85~265V 50/60Hz

# AC-DC POWER

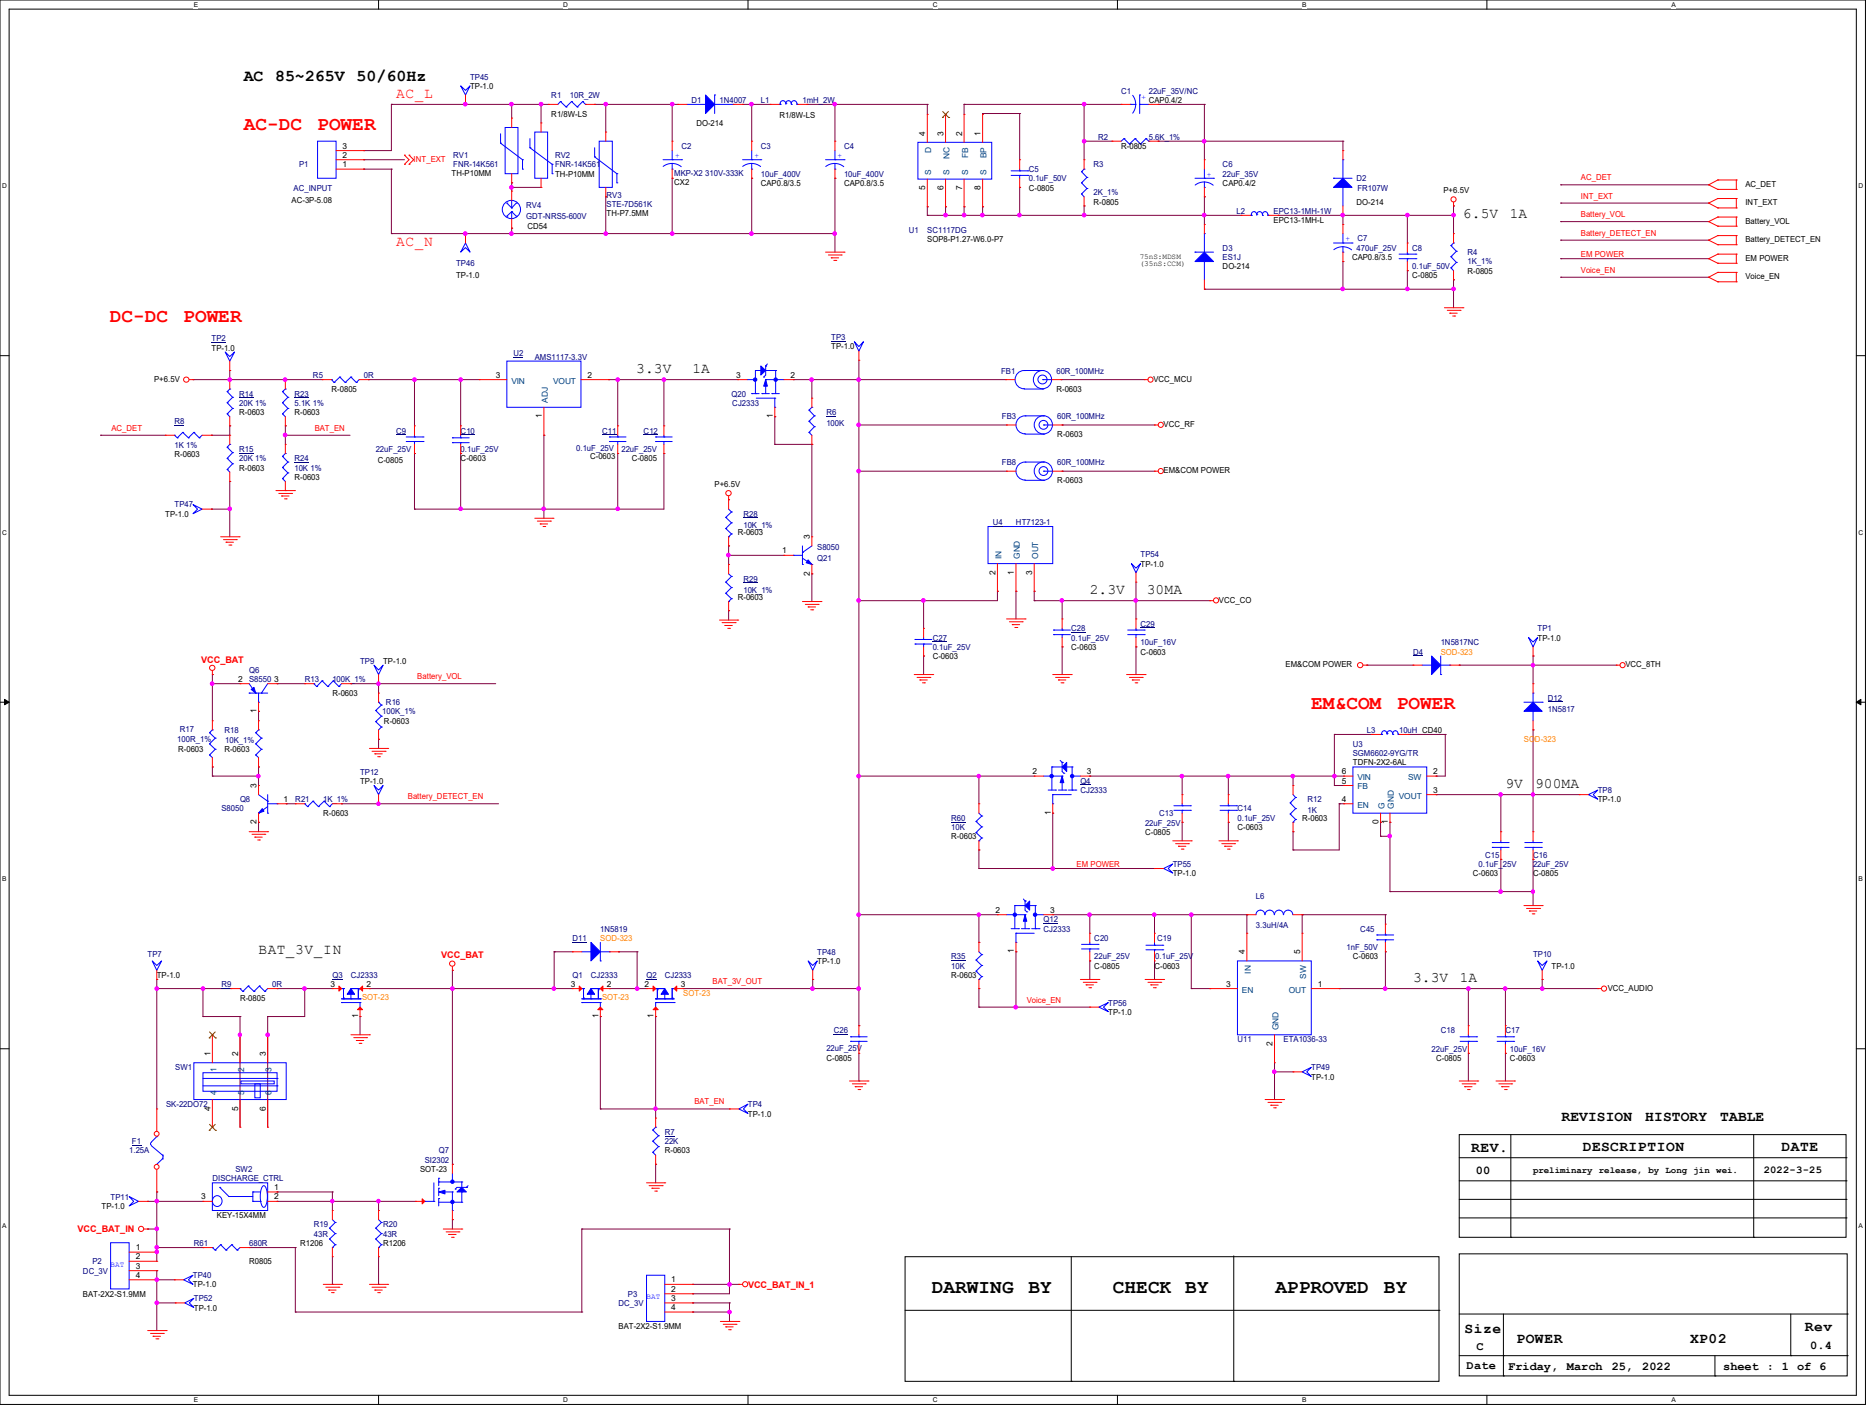
[picture p21: page 4]

1 SW 2 VOUT 3 EN 4 FB 5 VIN 6 G

D D

## POWER IN Power Managment

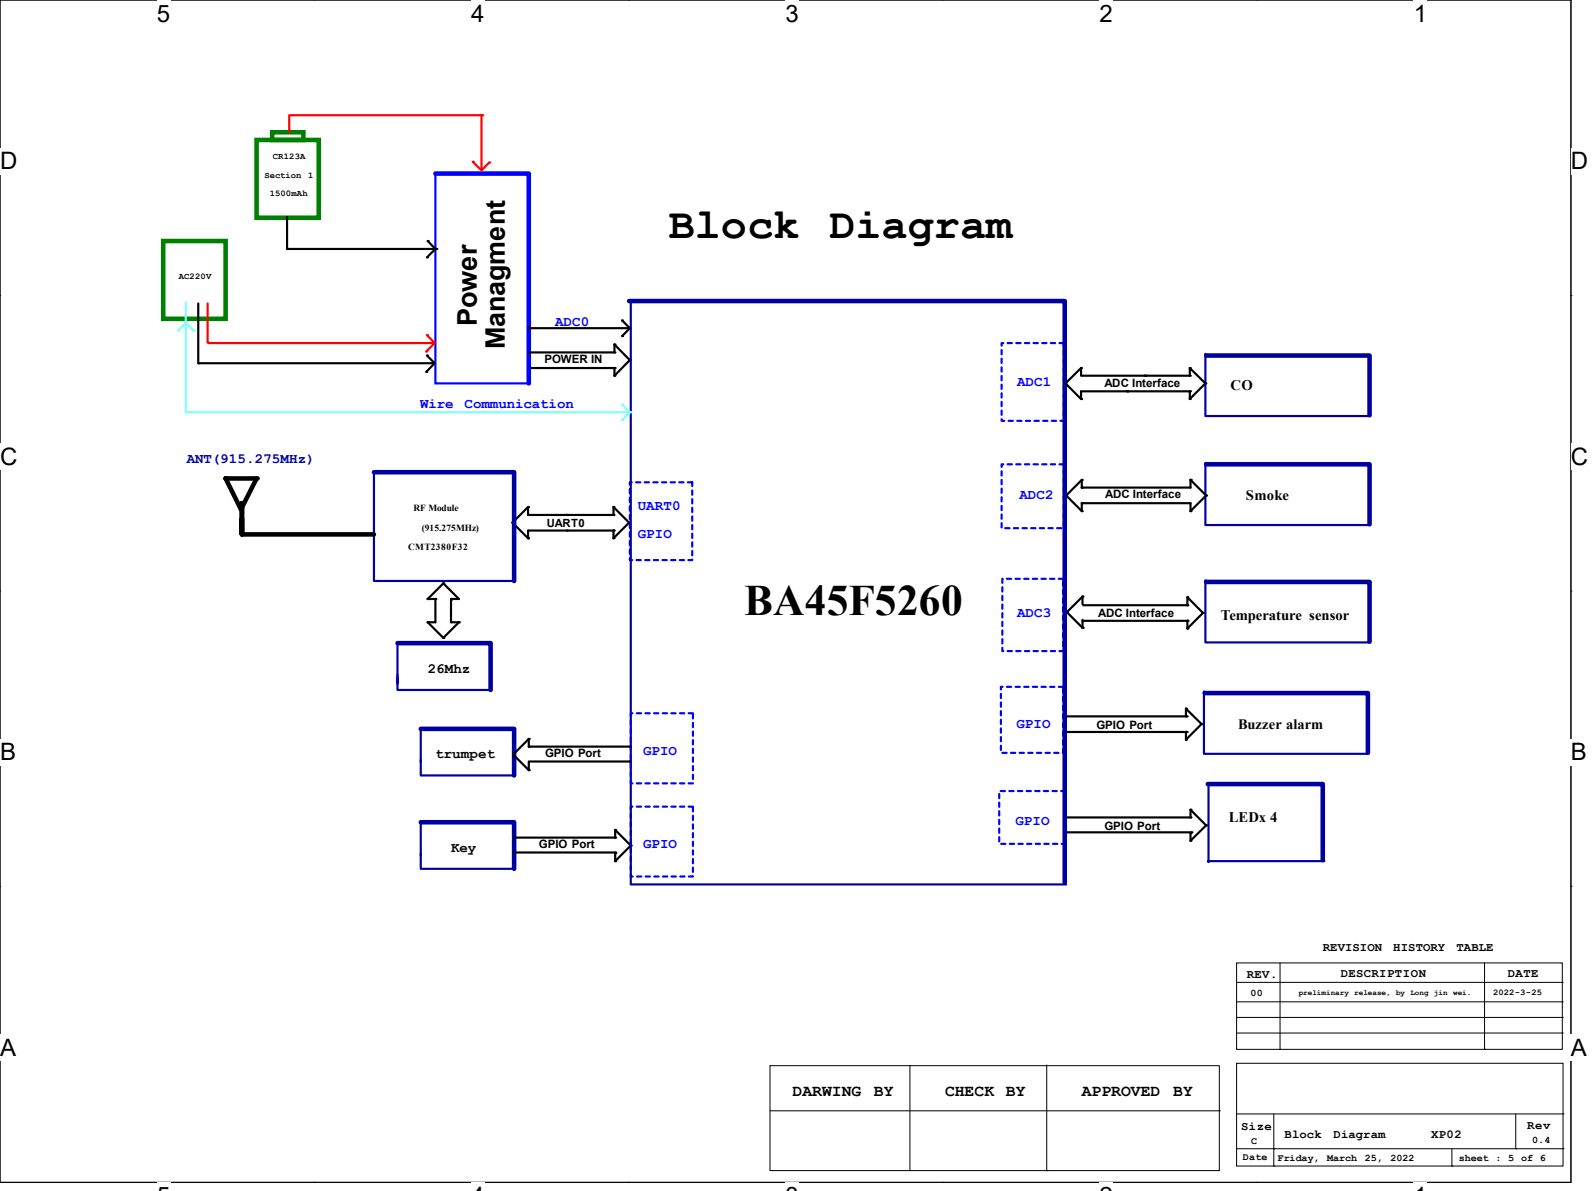
[picture p22: page 5]
REV.; DATE; preliminary release, by Long jin wei.; sheet : 5 of 6; DARWING BY; CHECK BY; APPROVED BY; GPIO; ADC3; ADC Interface; Temperature sensor; ADC1; UART0; RF Module; (915.275MHz); CMT2380F32; ANT(915.275MHz); Section 1; 1500mAh; GPIO Port; Buzzer alarm; LEDx 4; ADC0; 26Mhz; Block Diagram; Key; ADC2; Smoke; trumpet; Wire Communication

REVISION HISTORY TABLE
DESCRIPTION

0.4 Block Diagram Size

D D

CO

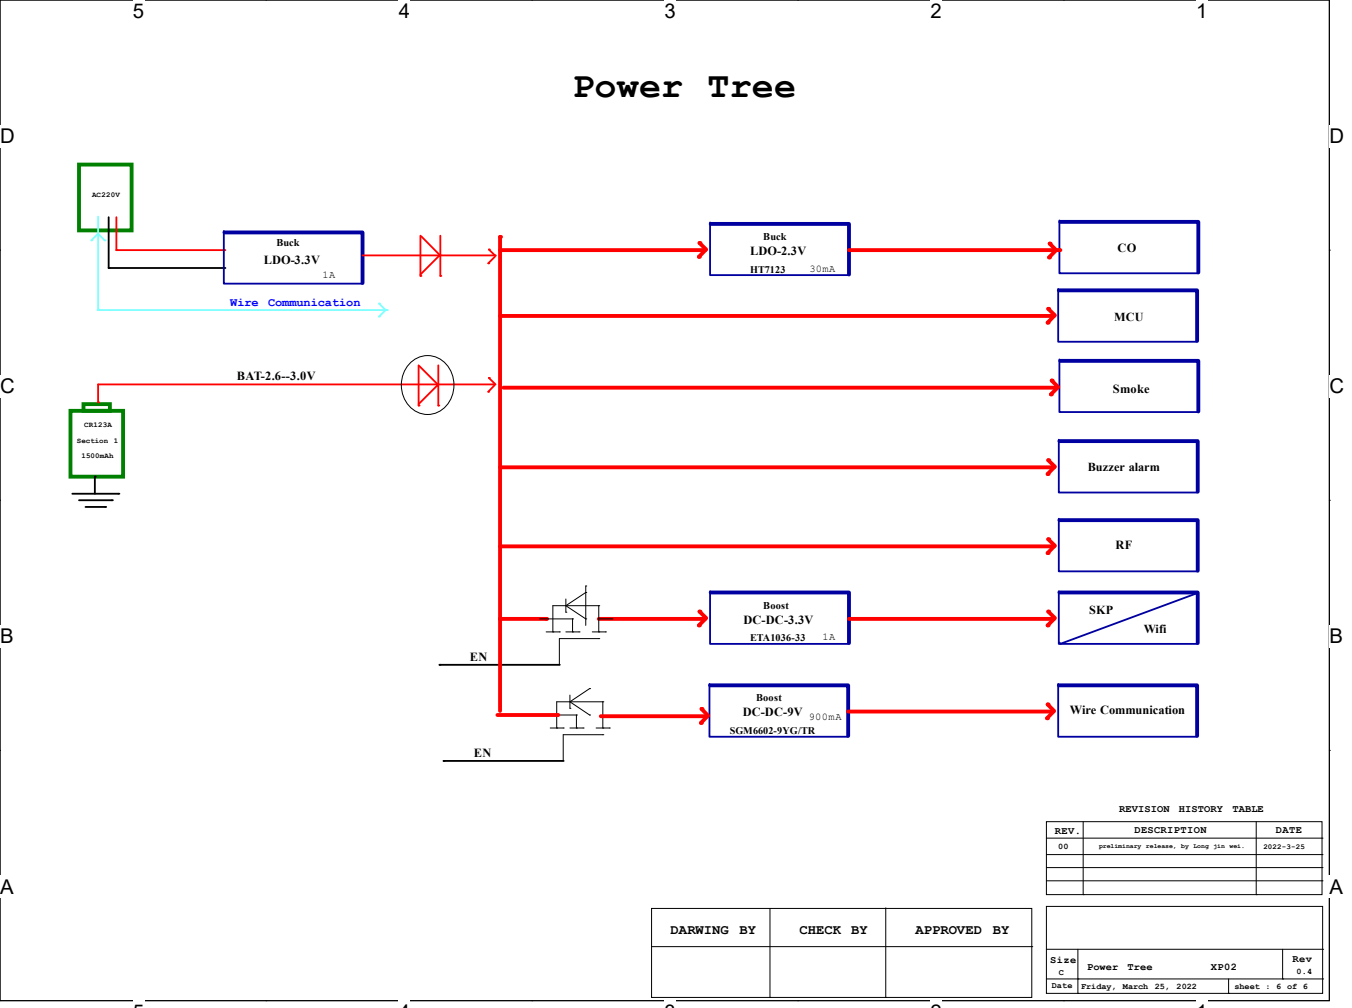
[picture p23: page 6]
0.4 Power Tree; DATE; REV.; preliminary release, by Long jin wei.; sheet : 6 of 6; DARWING BY; CHECK BY; APPROVED BY; MCU; Section 1; 1500mAh; Buzzer alarm; Power Tree; Smoke; Wire Communication; SKP; LDO-2.3V; LDO-3.3V; BAT-2.6--3.0V; ETA1036-33; SGM6602-9YG/TR; Buck; Boost; Wifi

REVISION HISTORY TABLE
DESCRIPTION
