xiaoshubaoVIP/XP02_WR/File/XP02/05 试产验证测试/02 EVT试产/丝印位号图B面.pdf

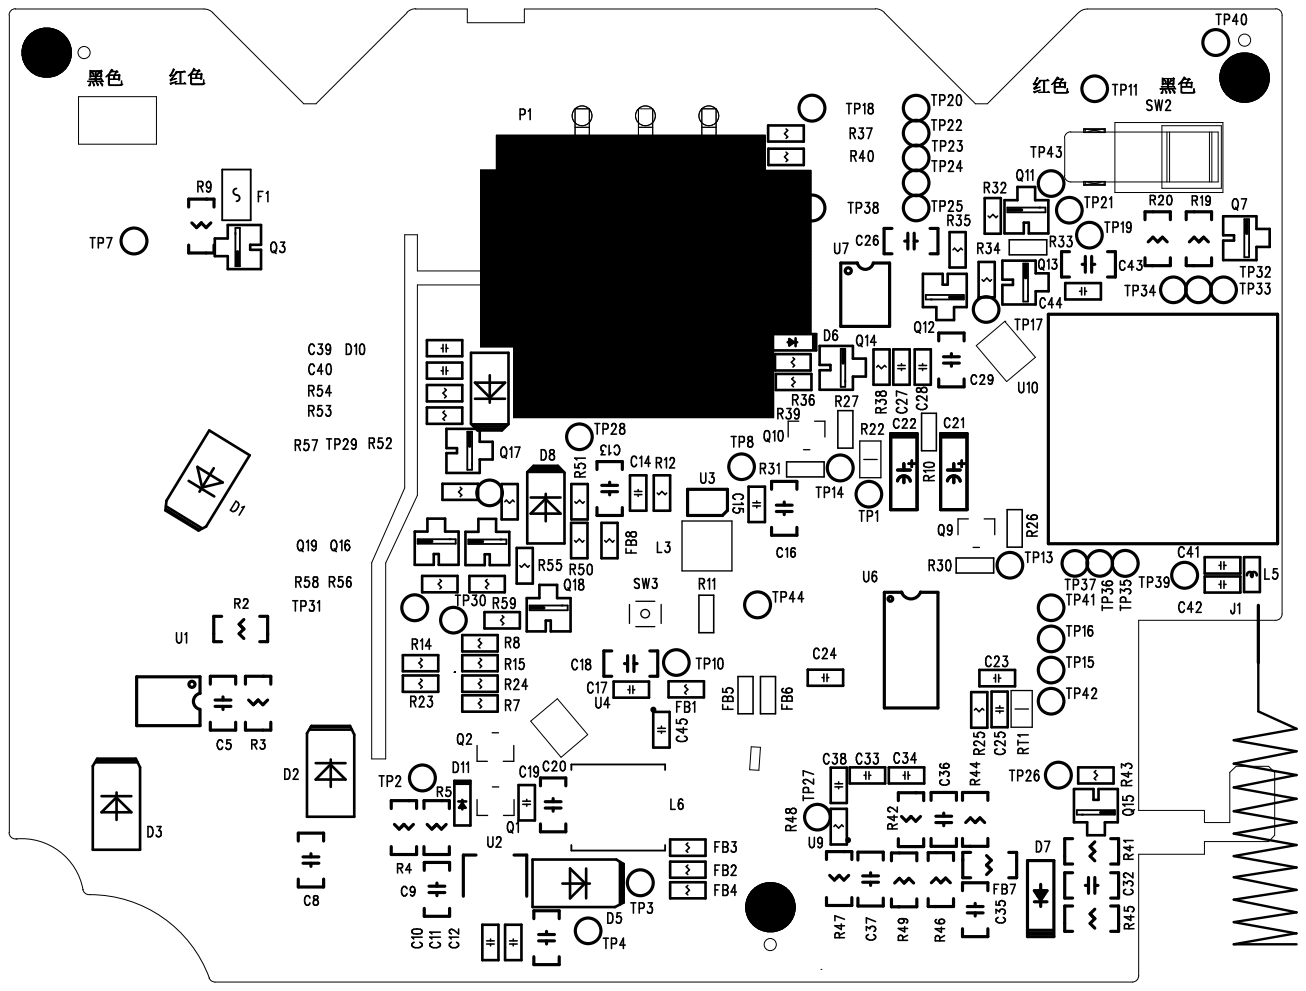
[picture p25: page 1]
