xiaoshubaoVIP/XP02_WR/File/XP02/03 详设方案/04 PCB文件/PCB板,XP01_V2.0主板PCB,FR-4,94V0,板厚1.6mm,黑油白字,双层板/丝印文件/丝印位号图A面.pdf.pdf

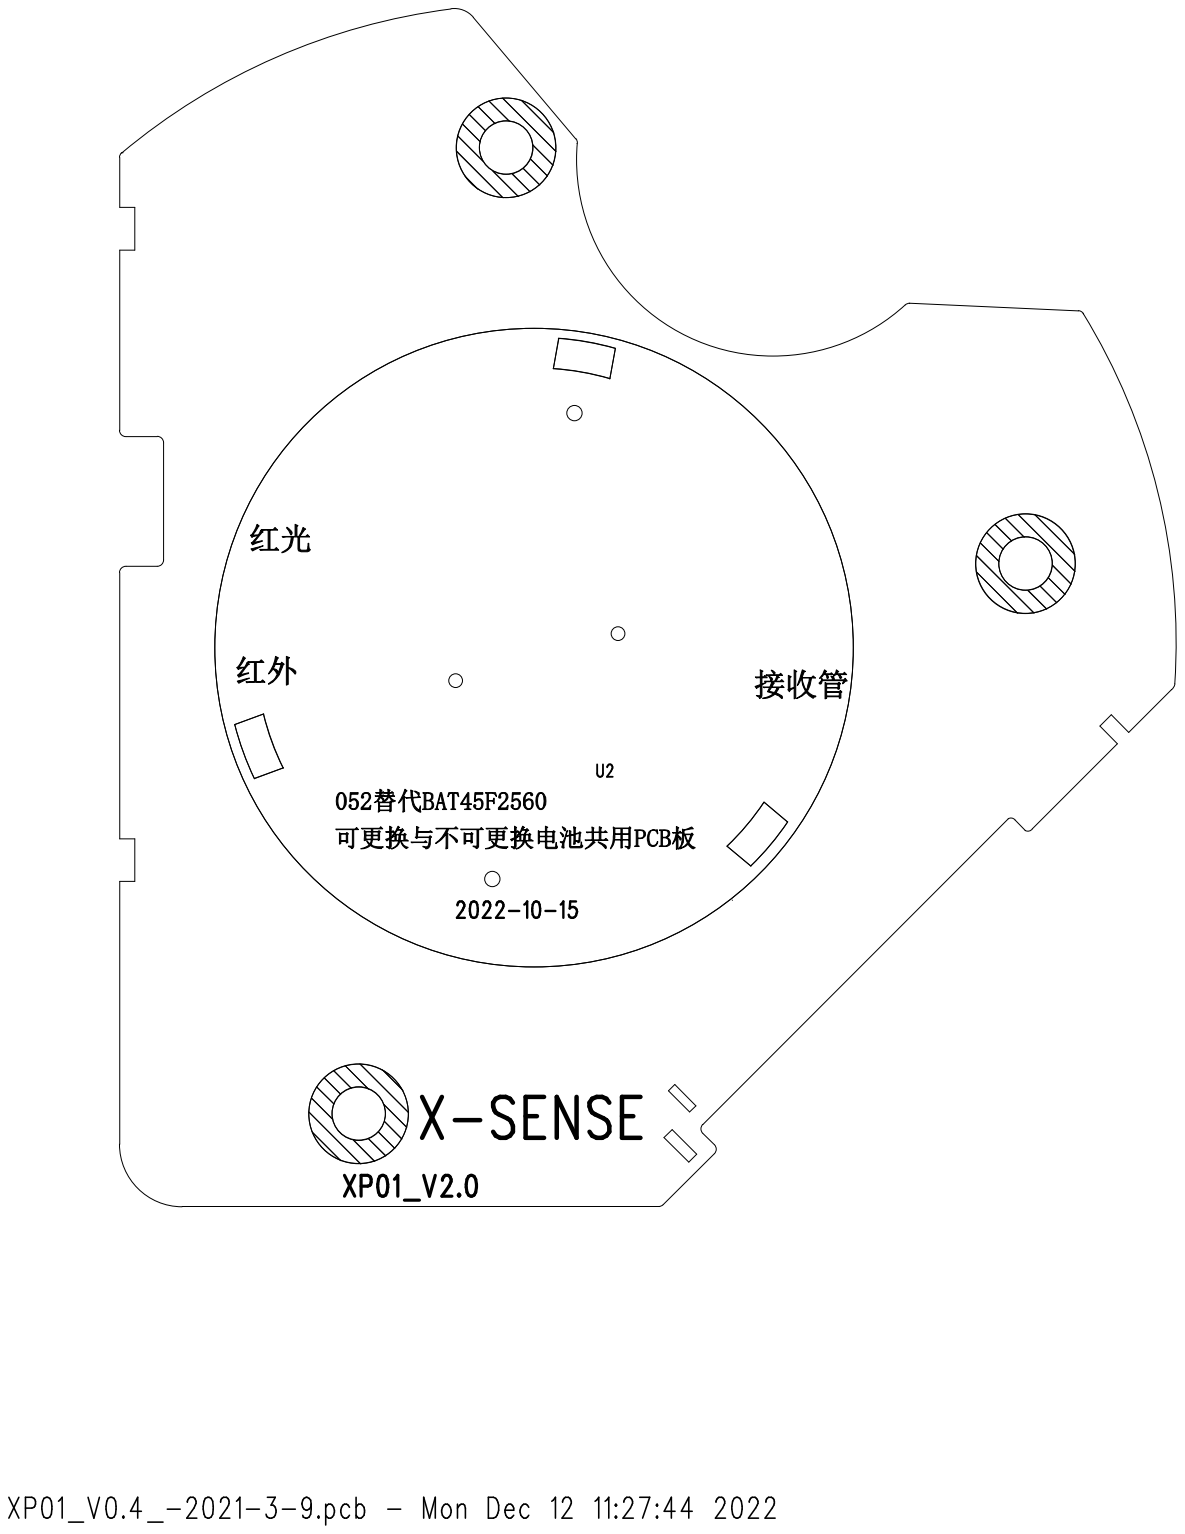
[picture p26: page 1]
