xiaoshubaoVIP/XP02_WR/File/XP02/03 详设方案/05 PCBA生产文件/PCB板,XP02主板PCB,FR-4,94V0,板厚1.6mm,黑油白字,双层板/丝印文件/丝印位号图B面.pdf

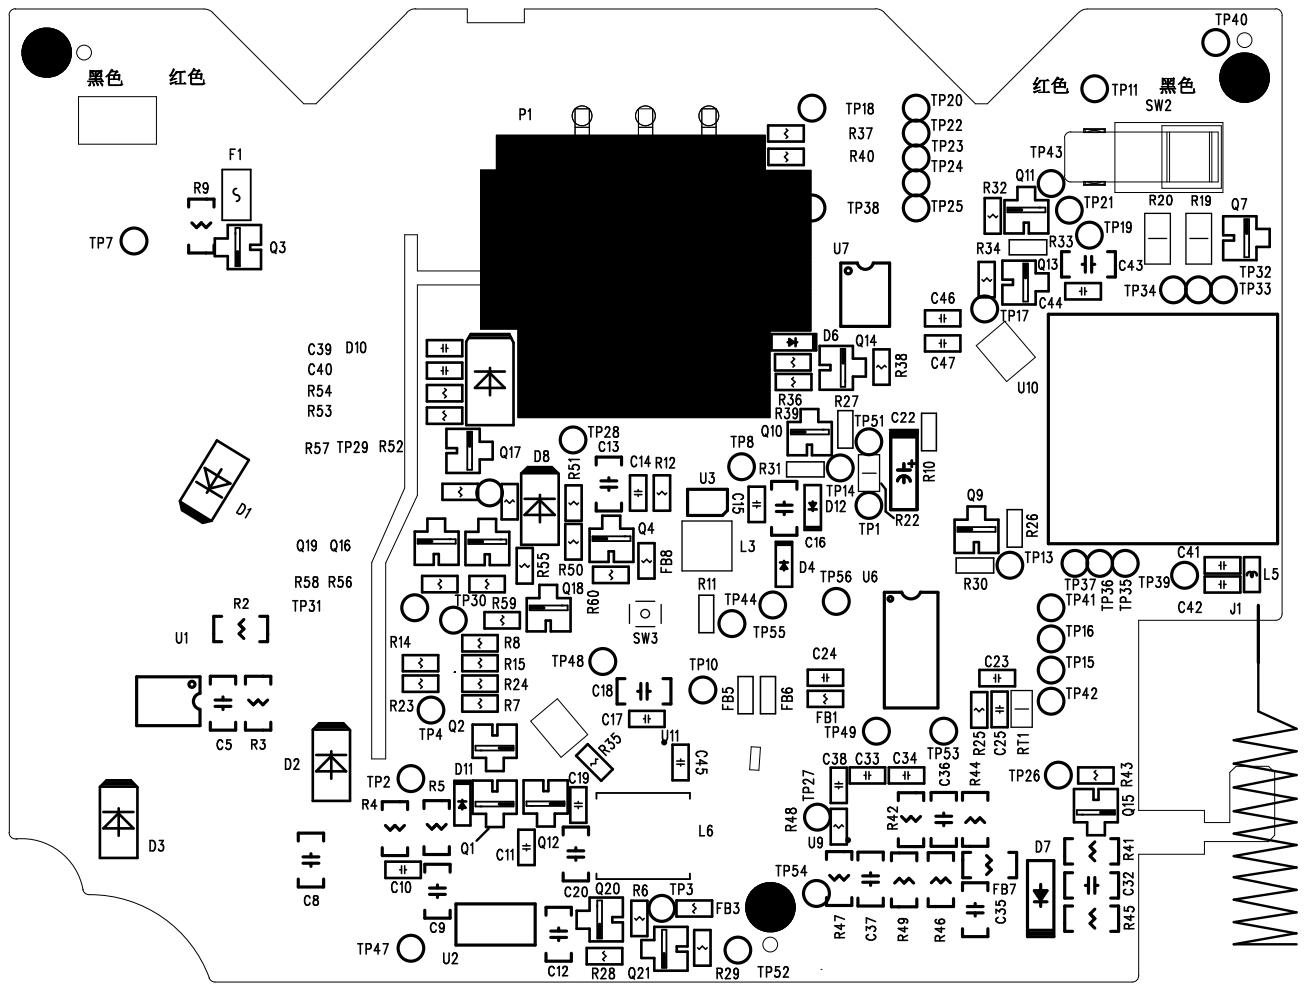
[picture p29: page 1]
