xiaoshubaoVIP/XP02_WR/(list of files, drawings)

Other design files:
File/XP02/03 详设方案/02 原理图文件/V0.4（EVT版本）/XP02-主板-V0.4-2022-3-15.DSN
File/XP02/03 详设方案/02 原理图文件/V0.6 (DVT版本）/XP02-主板-V0.6-2022-5-5.DSN
File/XP02/03 详设方案/04 PCB文件/V0.4（EVT版本）/XP02-主板-V0.4-2022-3-15.pcb
File/XP02/03 详设方案/04 PCB文件/V0.6 (DVT版本）/XP02-主板-V0.6-2022-5-5.pcb
File/XP02/03 详设方案/04 PCB文件/XP01-主板-V0.1-2022-9-22.pcb
