xiaoshubaoVIP/XP02_WR/Code/inc/sys_cfg.h

/* Define to prevent recursive inclusion -------------------------------------*/
#ifndef __SYS_CFG_H
#define __SYS_CFG_H



#define SUPPORT_DEBUG
#ifdef SUPPORT_DEBUG
#define SUPPORT_CARIBRATION_DEBUG

//#define SUPPORT_LIFE_TIME_DEBUG
//#define SUPPORT_SYSTEM_MODE_DEBUG
//#define SUPPORT_BATTERY_DEBUG
//#define SUPPORT_SMOKE_DEBUG
//#define SUPPORT_CO_DEBUG
//#define SUPPORT_NET_FUNCTION_DEBUG
//#define SUPPORT_HALT_DEBUG
//#define TEMP_DEBUG
#endif

//#define SENSOR_TEMP_TEST

#define TEMPCALIOLD

#define SUPPORT_UART 
//#define SUPPORT_OPA1_OUTPUT
//#define SUPPORT_CO_FUNCTION

#define SUPPORT_ISINK0_FOR_IR

//product life time
#define LIFE_TIME								(3650)//10*365   10 years+100 day(safe victor)
#define LIFE_TIME_FORBIT_MUTE					(3650+30)//10*365   10 years+100 day(safe victor)


#define SUPPORT_XP02_WR
//#define SUPPORT_XP02_S_WR
//#define SUPPORT_XP01_WR_5260
//#define SUPPORT_XP01_5260

//model name  
#ifdef  SUPPORT_XP02_WR
	#define SUPPORT_XP02_BOARD
	#define MODEL_NAME								"XP02_WR"
	#define SUPPORT_CO_FUNCTION
	#define SUPPORT_RF_NET_FUNCTION
	#define SUPPORT_SPEAK_FUNCTION
#elif defined(SUPPORT_XP02_S_WR)
	#define SUPPORT_XP02_BOARD
	#define MODEL_NAME								"XP02_S_WR"
	//#define SUPPORT_CO_FUNCTION
	#define SUPPORT_RF_NET_FUNCTION
	#define SUPPORT_SPEAK_FUNCTION
	
#elif defined(SUPPORT_XP01_WR_5260)
	#define SUPPORT_XP01_BOARD
	#define MODEL_NAME								"XP01_WR_5260"
	#define SUPPORT_CO_FUNCTION
	#define SUPPORT_RF_NET_FUNCTION

#elif defined(SUPPORT_XP01_5260)
	#define SUPPORT_XP01_BOARD
	#define MODEL_NAME								"XP01_5260"
	#define SUPPORT_CO_FUNCTION
#endif

// co spec set
#define SUPPORT_UL2034_UL217
//#define SUPPORT_EN50291_EN14604


//revision
#define FW_VERSION								"2.1.8"

//system frequence
#define _XTAL_FREQ								(4000000)		//    //4MHZ


//eeprom address
#define FLASH_ADDR_LIFE_TIME_DAYS_MSB			(0x00)
#define FLASH_ADDR_LIFE_TIME_DAYS_LSB			(FLASH_ADDR_LIFE_TIME_DAYS_MSB+1)
#define FLASH_ADDR_PAIRED_MODE_FLAG				(FLASH_ADDR_LIFE_TIME_DAYS_LSB+1)
#define FLASH_ADDR_CARIBRATION_VDD_MSB			(FLASH_ADDR_PAIRED_MODE_FLAG+1)
#define FLASH_ADDR_CARIBRATION_VDD_LSB			(FLASH_ADDR_CARIBRATION_VDD_MSB+1)
//SMOKE eeprom address
#define FLASH_ADDR_SMOKE_BASIC_CAMP_MSB     	(FLASH_ADDR_CARIBRATION_VDD_LSB+1)
#define FLASH_ADDR_SMOKE_BASIC_CAMP_LSB     	(FLASH_ADDR_SMOKE_BASIC_CAMP_MSB+1)
#define FLASH_ADDR_SMOKE_BASIC_TEMPERATURE  	(FLASH_ADDR_SMOKE_BASIC_CAMP_LSB+1)
#define FLASH_ADDR_SMOKE_VANOS_0            	(FLASH_ADDR_SMOKE_BASIC_TEMPERATURE+1)			//0x08
#define FLASH_ADDR_SMOKE_VANOS_1            	(FLASH_ADDR_SMOKE_VANOS_0+1)					//0x09
#define FLASH_ADDR_SMOKE_CARIBRATION_FLAG   	(FLASH_ADDR_SMOKE_VANOS_1+1)					//0x0A
#define FLASH_ADDR_SMOKE_CARIBRATION_OPA    	(FLASH_ADDR_SMOKE_CARIBRATION_FLAG+1)			//0x0B
#define SMOKE_CARIBRATION_FLAG					(0x5A)
//CO eeprom address
#define FLASH_ADDR_CARIBRATION_STEP            	(FLASH_ADDR_SMOKE_CARIBRATION_OPA+1)			//0x0C
#define FLASH_ADDR_CARIBRATION_PPM_SLOPE_MSB    (FLASH_ADDR_CARIBRATION_STEP+1)					//0x0D
#define FLASH_ADDR_CARIBRATION_PPM_SLOPE_LSB    (FLASH_ADDR_CARIBRATION_PPM_SLOPE_MSB+1)		//0X0E
#define FLASH_ADDR_CARIBRATION_PPM_OFFSET_MSB   (FLASH_ADDR_CARIBRATION_PPM_SLOPE_LSB+1)		//0x0F
#define FLASH_ADDR_CARIBRATION_PPM_OFFSET_LSB   (FLASH_ADDR_CARIBRATION_PPM_OFFSET_MSB+1)		//0x10
#define FLASH_ADDR_CARIBRATION_0_TEMPERATURE    (FLASH_ADDR_CARIBRATION_PPM_OFFSET_LSB+1)		//0x11
#define FLASH_ADDR_CARIBRATION_150_TEMPERATURE	(FLASH_ADDR_CARIBRATION_0_TEMPERATURE+1)		//0x12
#define FLASH_ADDR_CO_CARIBRATION_FLAG          (FLASH_ADDR_CARIBRATION_150_TEMPERATURE+1)		//0x13
#define CO_CARIBRATION_FLAG						(0xAA)
#ifdef SUPPORT_SPEAK_FUNCTION
#define FLASH_ADDR_SELF_LOCATION                (FLASH_ADDR_CO_CARIBRATION_FLAG+1)				//0x14
#endif

//time set
#define BATTERY_CHECK_COUNT                     (6)
#define ONE_DAY                                 (10500)
#define STANDBY_MODE_CYCLE_COUNT                (6)
#define LIFETIME_MUTE_COUT						(7920)					//22h
#define LOWBAT_MUTE_COUT						(3600)					//10h
#define LATCHING_CO_ALARM						(3)						

//led control set
#define LED_ON_TIME_FAULT                       (50000)					// 15ms
#define LED_ON_TIME_STANDBY                 	(3000)					// 6ms-->3ms

//voltage set
#define EMC_BATTERY_DEFFER                      (70)					// for EMC bat

#define CAIL_BAT_LEVEL_MIX						(3000)
#define CAIL_BAT_LEVEL_MAX						(3300)
#define BATTERY_LEVEL_2_IN_3					(2800)


#define BATTERY_LEVEL_1_IN_3					(2700)
#define BATTERY_LEVEL_LOW						(2650)


/**
  * @}
  */

#endif /* __SYS_CFG_H */
