xiaoshubaoVIP/XP02_WR/Code/src/Polling.c

/*************************************************************************
* Copyright (c) 2018 Shenzhen Xiaojun technology co., Ltd.All right reserved.
* Author: chaofa.yan
* Date: 2018/04/25
* History Information
* Author 		Date 		Description
* chaofa.yan	2018/04/25 	Created the file
*************************************************************************/
#include "Polling.h"
#include "main.h"
#include "RF.h"
#include "Co.h"
#include "Smoke.h"


static TmrInfo TimerInfo[eTmrHdlMax];

void TmrInitHeader(void)
{
	uint8_t i = eTmrHdlMax;
	TmrInfo* pTmrInfo = &TimerInfo[0];
	while(i > 0)
	{
		CLEAN_TMR_FLAG(pTmrInfo->TimerFlag, eTmrActitvityFlag);
		CLEAN_TMR_FLAG(pTmrInfo->TimerFlag, eTmrTimeOutFlag);
		pTmrInfo->CurCnt = 0;
		pTmrInfo->ReloadCnt = 0;
		pTmrInfo->pCtx = NULL;
		i--;
		pTmrInfo++;
	}
}


void TmrInsertTimer(eTmrHdl eHandle, TmrCnt ReloadCnt, void* pCtx)
{
	TmrInfo* pTmrInfo = NULL;	
	if(eHandle < eTmrHdlMax)
	{
		pTmrInfo = &TimerInfo[eHandle];
		SET_TMR_FLAG(pTmrInfo->TimerFlag, eTmrActitvityFlag);
		pTmrInfo->CurCnt = ReloadCnt;
		pTmrInfo->ReloadCnt = ReloadCnt;
		pTmrInfo->pCtx = pCtx;
		SetHaltFlag((uint32_t)1<<eHandle);
	}
}

void TmrDeleteTimer(eTmrHdl eHandle)
{
	TmrInfo* pTmrInfo = NULL;
	
	if(eHandle < eTmrHdlMax)
	{
		pTmrInfo = &TimerInfo[eHandle];
		CLEAN_TMR_FLAG(pTmrInfo->TimerFlag, eTmrActitvityFlag);
		CLEAN_TMR_FLAG(pTmrInfo->TimerFlag, eTmrTimeOutFlag);
		pTmrInfo->CurCnt = 0;
		pTmrInfo->ReloadCnt = 0;
		pTmrInfo->pCtx = NULL;
		ClearHaltFlag((uint32_t)1<<eHandle);
	}
}
#ifdef SUPPORT_RF_NET_FUNCTION
/**********************************************************************/
//Description:		PollingUartSend (for stack overflow)
//Parameters:	
//Return:
//Date:  
//author:		    quanwu.xu
/**********************************************************************/
void PollingUartSend(void)
{
	uint32_t Ticks = 0;
	TmrInfo* pTmrInfo = &TimerInfo[eTmrHdlUartSendTimeout];

	Ticks = GetTicks();

	if(Ticks > 0)
	{
		if(pTmrInfo->TimerFlag & eTmrActitvityFlag)
		{
			if(pTmrInfo->CurCnt > Ticks)
			{
				pTmrInfo->CurCnt -= Ticks;
			}
			else
			{
				pTmrInfo->CurCnt = pTmrInfo->ReloadCnt;
				SET_TMR_FLAG(pTmrInfo->TimerFlag, eTmrTimeOutFlag);
			}
		}
	}

	if(pTmrInfo->TimerFlag & eTmrTimeOutFlag)
	{
		CLEAN_TMR_FLAG(pTmrInfo->TimerFlag, eTmrTimeOutFlag);
		PollingUartSendTimeout((void *)((uint16_t)(pTmrInfo->pCtx)++));
	}
}
#endif
void Polling(void)
{

	uint32_t Ticks = 0;
	uint8_t i = eTmrHdlMax;
	TmrInfo* pTmrInfo = &TimerInfo[0];

	Ticks = GetTicks();

	if(Ticks > 0)
	{
		while(i > 0)
		{
			if(pTmrInfo->TimerFlag & eTmrActitvityFlag)
			{
				if(pTmrInfo->CurCnt > Ticks)
				{
					pTmrInfo->CurCnt -= Ticks;
				}
				else
				{
					pTmrInfo->CurCnt = pTmrInfo->ReloadCnt;
					SET_TMR_FLAG(pTmrInfo->TimerFlag, eTmrTimeOutFlag);
				}
			}			
			i--;
			pTmrInfo++;
		}

		if(TimerInfo[eTmrHdlKeyScan].TimerFlag & eTmrTimeOutFlag)
		{
			CLEAN_TMR_FLAG(TimerInfo[eTmrHdlKeyScan].TimerFlag, eTmrTimeOutFlag);
			PollingKeyScan();
		}

		if(TimerInfo[eTmrHdlKeyDouble].TimerFlag & eTmrTimeOutFlag)
		{
			CLEAN_TMR_FLAG(TimerInfo[eTmrHdlKeyDouble].TimerFlag, eTmrTimeOutFlag);
			PollingDoubleClickScan();
		}
		
		if(TimerInfo[eTmrHdlLedOff].TimerFlag & eTmrTimeOutFlag)
		{
			CLEAN_TMR_FLAG(TimerInfo[eTmrHdlLedOff].TimerFlag, eTmrTimeOutFlag);
			TmrDeleteTimer(eTmrHdlLedOff);
			PollingLEDOff();			
		}
		
		if(TimerInfo[eTmrHdlBeepOff].TimerFlag & eTmrTimeOutFlag)		{
			CLEAN_TMR_FLAG(TimerInfo[eTmrHdlBeepOff].TimerFlag, eTmrTimeOutFlag);
			TmrDeleteTimer(eTmrHdlBeepOff);
			PollingBeepOff();			
		}

		if(TimerInfo[eTmrHdlSmoke].TimerFlag & eTmrTimeOutFlag)
		{
			CLEAN_TMR_FLAG(TimerInfo[eTmrHdlSmoke].TimerFlag, eTmrTimeOutFlag);
			PollingSmoke(TimerInfo[eTmrHdlSmoke].pCtx);
		}

		if(TimerInfo[eTmrHdlMuteTimeout].TimerFlag & eTmrTimeOutFlag)
		{
			CLEAN_TMR_FLAG(TimerInfo[eTmrHdlMuteTimeout].TimerFlag, eTmrTimeOutFlag);
			PollingMuteTimeout(TimerInfo[eTmrHdlMuteTimeout].pCtx);
		}

		if(TimerInfo[eTmrHdlCo].TimerFlag & eTmrTimeOutFlag)
		{
			CLEAN_TMR_FLAG(TimerInfo[eTmrHdlCo].TimerFlag, eTmrTimeOutFlag);
			PollingCo(TimerInfo[eTmrHdlCo].pCtx);
		}

#ifdef SUPPORT_RF_NET_FUNCTION
		if(TimerInfo[eTmrHdlRFLed].TimerFlag & eTmrTimeOutFlag) 	{
			CLEAN_TMR_FLAG(TimerInfo[eTmrHdlRFLed].TimerFlag, eTmrTimeOutFlag);
			RFLedFlash(TimerInfo[eTmrHdlRFLed].pCtx);
		}

		if(TimerInfo[eTmrHdlRFTimeout].TimerFlag & eTmrTimeOutFlag) 	{
			CLEAN_TMR_FLAG(TimerInfo[eTmrHdlRFTimeout].TimerFlag, eTmrTimeOutFlag);
			PollingRfTimeout(TimerInfo[eTmrHdlRFTimeout].pCtx);
		}

		if(TimerInfo[eTmrHdlUartSendTimeout].TimerFlag & eTmrTimeOutFlag){
			CLEAN_TMR_FLAG(TimerInfo[eTmrHdlUartSendTimeout].TimerFlag, eTmrTimeOutFlag);
			PollingUartSendTimeout((void *)((uint16_t)(TimerInfo[eTmrHdlUartSendTimeout].pCtx)++));
		}

		if(TimerInfo[eTmrHdlGreenLedFlicker].TimerFlag & eTmrTimeOutFlag)		{
			CLEAN_TMR_FLAG(TimerInfo[eTmrHdlGreenLedFlicker].TimerFlag, eTmrTimeOutFlag);
			PollingGREENLEDFlicker(TimerInfo[eTmrHdlGreenLedFlicker].pCtx);
		}
		
		if(TimerInfo[eTmrHdlGreenLedOff].TimerFlag & eTmrTimeOutFlag)		{
			CLEAN_TMR_FLAG(TimerInfo[eTmrHdlGreenLedOff].TimerFlag, eTmrTimeOutFlag);
			TmrDeleteTimer(eTmrHdlGreenLedOff);
			PollingGreenLEDOff();			
		}
#endif

#ifdef SUPPORT_SPEAK_FUNCTION
		if(TimerInfo[eTmrHdlSetLocation].TimerFlag & eTmrTimeOutFlag)
		{
			CLEAN_TMR_FLAG(TimerInfo[eTmrHdlSetLocation].TimerFlag, eTmrTimeOutFlag);
			PollingSetLocation(TimerInfo[eTmrHdlSetLocation].pCtx);
			TmrDeleteTimer(eTmrHdlSetLocation);
		}

		if(TimerInfo[eTmrHdlSetLocationDisplay].TimerFlag & eTmrTimeOutFlag)
		{
			CLEAN_TMR_FLAG(TimerInfo[eTmrHdlSetLocationDisplay].TimerFlag, eTmrTimeOutFlag);
			PollingSetLocationDisplay();
		}
#endif
	}
}

void* TmrGetCtx(eTmrHdl eHandle)
{
	void* pCtx = NULL;
	
	if(eHandle < eTmrHdlMax)
	{
		pCtx = TimerInfo[eHandle].pCtx;
	}

	return (pCtx);
}

void TmrSetCurCnt(eTmrHdl eHandle, TmrCnt CurCnt)
{
	if(eHandle < eTmrHdlMax)
	{
		TimerInfo[eHandle].CurCnt = CurCnt;
	}
}

void TmrResetCurCnt(eTmrHdl eHandle)
{
	if(eHandle < eTmrHdlMax)
	{
		TimerInfo[eHandle].CurCnt = TimerInfo[eHandle].ReloadCnt;
	}
}

uint32_t TmrGetMbs(void)
{
	return (eTmrHdlMax);
}
