xiaoshubaoVIP/XP02_WR/Code/inc/NTC.h

/**
  ******************************************************************************
  * @file    NTC.h
  * @author  zhenrong.peng
  * @version V1.0
  * @date    26-04-2017
  * @brief   
  *****************************************************************************
  */ 

/* Define to prevent recursive inclusion -------------------------------------*/
#ifndef __NTC_H__
#define __NTC_H__

/* Includes ------------------------------------------------------------------*/
/* Exported types ------------------------------------------------------------*/
/* Exported constants --------------------------------------------------------*/
/* Exported macro ------------------------------------------------------------*/

//smoke temp compensation coefficents


#define     SM_TN_20   (900)
#define     SM_TN_19   (900) 
#define     SM_TN_18   (900) 
#define     SM_TN_17   (900) 
#define     SM_TN_16   (900) 
#define     SM_TN_15   (900) 
#define     SM_TN_14   (900)
#define     SM_TN_13   (900) 
#define     SM_TN_12   (900) 
#define     SM_TN_11   (900) 
#define     SM_TN_10   (900)
#define     SM_TN_9    (900)
#define     SM_TN_8    (900)
#define     SM_TN_7    (900) 
#define     SM_TN_6    (904) 

#define     SM_TN_5    (909)
#define     SM_TN_4    (913)
#define     SM_TN_3    (917) 
#define     SM_TN_2    (921)  
#define     SM_TN_1    (924) 

#define     SM_TP_0    (928)  
#define     SM_TP_1    (931)  
#define     SM_TP_2    (935)  
#define     SM_TP_3    (938)     
#define     SM_TP_4    (942)  
#define     SM_TP_5    (945) 
#define     SM_TP_6    (948) 
#define     SM_TP_7    (951) 
#define     SM_TP_8    (954) 
#define     SM_TP_9    (957) 
#define     SM_TP_10   (959) 
#define     SM_TP_11   (962) 
#define     SM_TP_12   (966) 
#define     SM_TP_13   (968) 
#define     SM_TP_14   (971) 
#define     SM_TP_15   (974) 
#define     SM_TP_16   (976) 
#define     SM_TP_17   (979) 
#define     SM_TP_18   (982) 
#define     SM_TP_19   (984) 
#define     SM_TP_20   (987) 

#define     SM_TP_21   (989) 
#define     SM_TP_22   (992) 
#define     SM_TP_23   (995) 
#define     SM_TP_24   (997) 
#define     SM_TP_25   (1000) 
#define     SM_TP_26   (1002)
#define     SM_TP_27   (1005)
#define     SM_TP_28   (1008)
#define     SM_TP_29   (1012) 
#define     SM_TP_30   (1014) 
#define     SM_TP_31   (1017) 
#define     SM_TP_32   (1020) 
#define     SM_TP_33   (1023) 
#define     SM_TP_34   (1026) 
#define     SM_TP_35   (1029) 
#define     SM_TP_36   (1032)
#define     SM_TP_37   (1035) 
#define     SM_TP_38   (1037) 
#define     SM_TP_39   (1038) 
#define     SM_TP_40   (1038) 
#define     SM_TP_41   (1041)
#define     SM_TP_42   (1043)
#define     SM_TP_43   (1045)
#define     SM_TP_44   (1047)
#define     SM_TP_45   (1049)

#define     SM_TP_46   (1051)
#define     SM_TP_47   (1053)
#define     SM_TP_48   (1054)
#define     SM_TP_49   (1057)
#define     SM_TP_50   (1057)
#define     SM_TP_51   (1058)
#define     SM_TP_52   (1058)
#define     SM_TP_53   (1059)

#define     SM_TP_54   (1060)
#define     SM_TP_55   (1060)
#define     SM_TP_56   (1060)
#define     SM_TP_57   (1060)
#define     SM_TP_58   (1060)
#define     SM_TP_59   (1050)
#define     SM_TP_60   (1050)
#define     SM_TP_61   (1050)
#define     SM_TP_62   (1050)
#define     SM_TP_63   (1050)
#define     SM_TP_64   (1050)
#define     SM_TP_65   (1050)
#define     SM_TP_66   (1050)
#define     SM_TP_67   (1050)
#define     SM_TP_68   (1050)
#define     SM_TP_69   (1050)
#define     SM_TP_70   (1050)



#define     SM_VOL_25   (1050) 
#define     SM_VOL_26   (1030)
#define     SM_VOL_27   (1020)
#define     SM_VOL_28   (1015)
#define     SM_VOL_29   (1010) 
#define     SM_VOL_30   (1000) 



/* Exported variables --------------------------------------------------------*/
/* Exported functions --------------------------------------------------------*/



#endif /* __NTC_H__ */



/************************END OF FILE**************************/
