xiaoshubaoVIP/XP02_WR/Code/inc/Module.h

/****************************************************************************/
/*	File   :             F:\Smoker\HTK-BA45F5250\trunk\src\inc\Module.h               */
/*	Author :                       songjiang                                */
/*	Version:                          V1.0                                  */
/*	Date   :                    2019/7/25,16:51:14                         */
/********************************Modify History******************************/
/*   yy/mm/dd     F. Lastname    Description of Modification                */
/****************************************************************************/
/*	Attention:                                                              */
/*	CopyRight:                CopyRight 2017--2025                          */
/*           Shenzhen Xiaojun Technology Co., Ltd.  Allright Reserved        */
/*	Project :                      SC01                           */
/****************************************************************************/

#ifndef __MODULE_H_
#define __MODULE_H_

#include "Key.h"
#include "Smoke.h"
#include "E2prom.h"
#include "Adc.h"
#include "usart.h"
#include "ntc.h"
#include "PwrManager.h"
#include "polling.h"
#include "Holtek_Timer.h"
#include "RF.h"
#include "Co.h"
#include "WiredNet.h"
#include "Speaker.h"
#endif
